palzhj/uFCv2/UFCV2.pdf

# CLK

FPGA_TDO MGTCLK¹¹⁵_P⁰ MGTCLK¹¹⁵_N⁰ | MGTCLK¹¹⁵_P¹ MGTCLK¹¹⁵_N¹ | MGTCLK¹¹⁶_P⁰ MGTCLK¹¹⁶_N⁰ | MGTCLK¹¹⁶_P¹ MGTCLK¹¹⁶_N¹ | MGTCLK¹¹⁷_P⁰ MGTCLK¹¹⁷_N⁰ | MGTCLK¹¹⁷_P¹ MGTCLK¹¹⁷_N¹ | MGTCLK¹¹⁸_P⁰ MGTCLK¹¹⁸_N⁰ | MGTCLK¹¹⁸_P¹ MGTCLK¹¹⁸_N¹

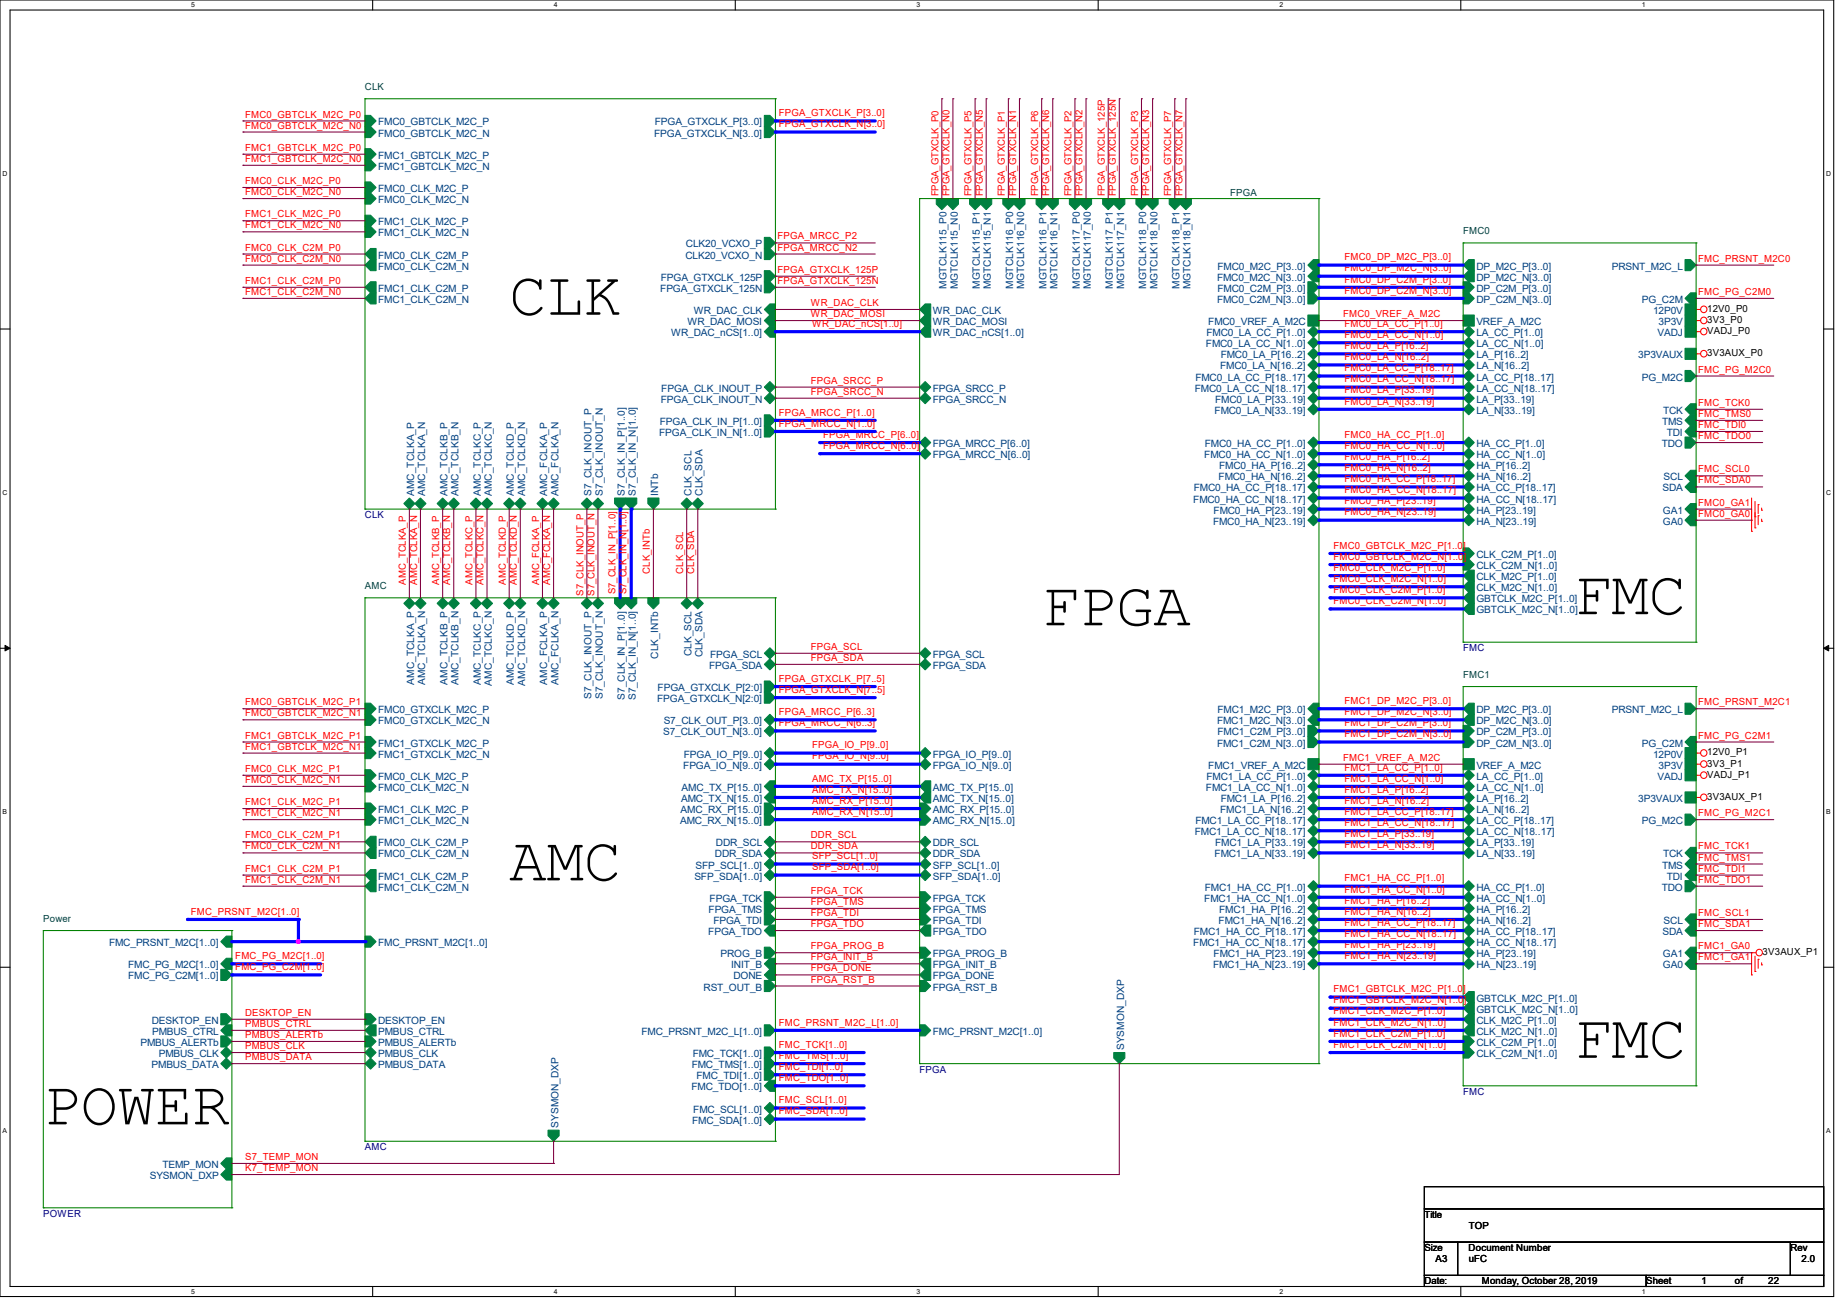
[picture p5: page 1]
FPGA; AMC; FMC; POWER; VADJ_P0; VADJ_P1; 3V3AUX_P0; 3V3AUX_P1; 3V3AUX_P1 Title Size; Document Number; Rev Date:; Sheet; of uFC; 2.0 TOP; Monday, October 28, 2019; 22 Title Size; FMC0_LA_CC_N[18..17] FMC0_LA_N[33..19] FMC0_LA_P[33..19] FMC0_LA_CC_P[18..17] FMC0_HA_CC_P[1..0] FMC0_HA_CC_N[1..0] FMC0_HA_N[16..2] FMC0_HA_P[16..2] FMC0_HA_CC_P[18..17] FMC0_HA_P[23..19] FMC0_HA_N[23..19] FMC0_HA_CC_N[18..17] FPGA_SCL FPGA_SDA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

# MP_3V3 MP_3V3 AMC_MP_3V3

J1GND 85 PWR 84 PS0# 83 GND 82 FCLKA- 81 FCLKA+ 80 GND 79 TCLKB- 78 TCLKB+ 77 GND 76 TCLKA- 75 TCLKA+ 74 GND 73 PWR 72 SDA_L 71 GND 70 RX7- 69 RX7+ 68 GND 67 TX7- 66 TX7+ 65 GND 64 RX6- 63 RX6+ 62 GND 61 TX6- 60 TX6+ 59 GND 58 PWR 57 SCL_L 56 GND 55 RX5- 54 RX5+ 53 GND 52 TX5- 51 TX5+ 50 GND 49 RX4- 48 RX4+ 47 GND 46 TX4- 45 TX4+ 44 GND 43 PWR 42 ENABLE# 41 GND 40 RX3- 39 RX3+ 38 GND 37 TX3- 36 TX3+ 35 GND 34 RX2- 33 RX2+ 32 GND 31 TX2- 30 TX2+ 29 GND 28 PWR 27 GA2 26 GND 25 RX1- 24 RX1+ 23 GND 22 TX1- 21 TX1+ 20 GND 19 PWR 18 GA1 17 GND 16 RX0- 15 RX0+ 14 GND 13 TX0- 12 TX0+ 11 GND 10 PWR 9 RSRVD8 8 GND 7 RSRVD6 6 GA0 5 MP 4 PS1# 3 PWR 2 GND 1

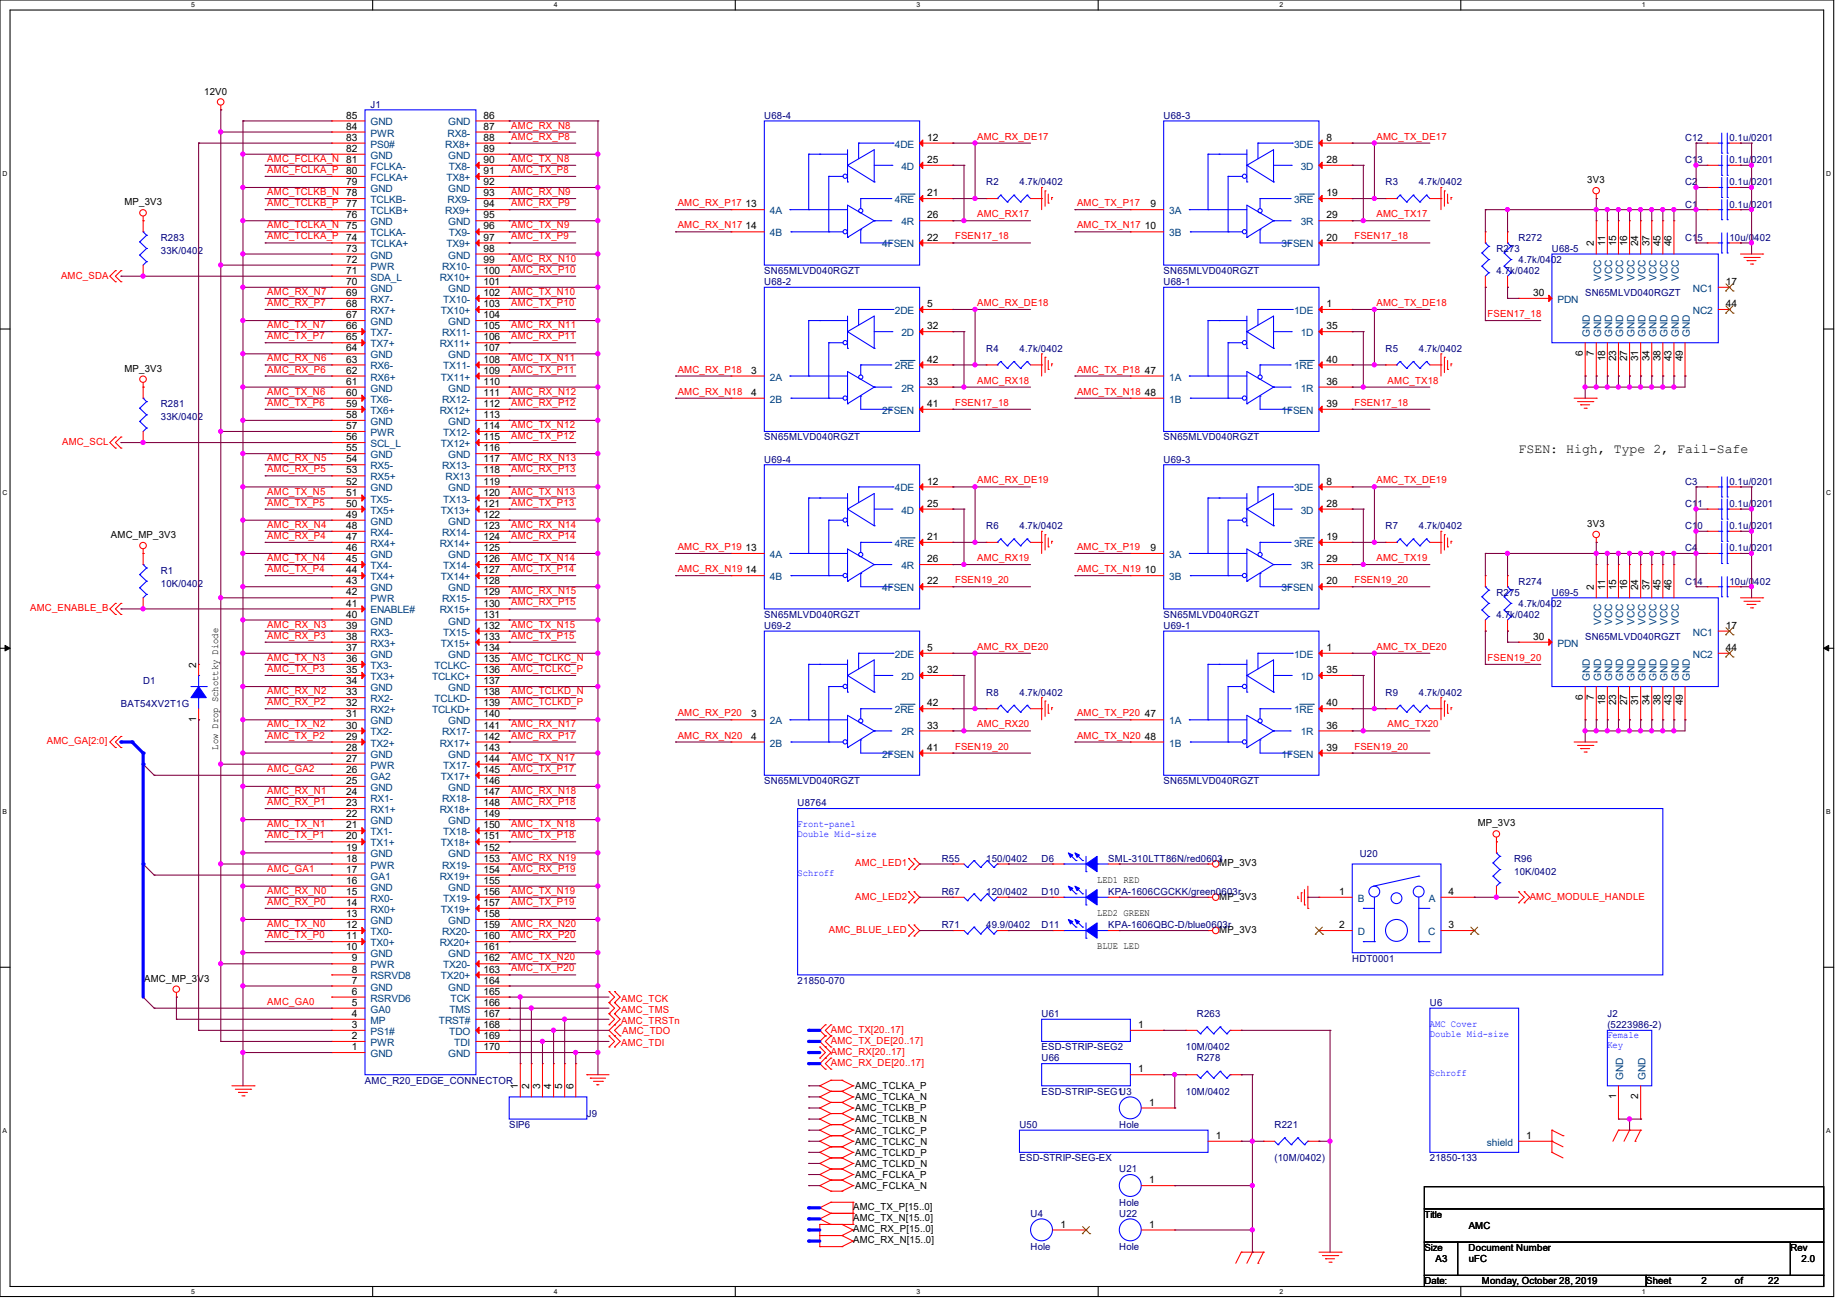
[picture p6: page 2]

GND 86 RX8- 87 RX8+ 88 GND 89 TX8- 90 TX8+ 91 GND 92 RX9- 93 RX9+ 94 GND 95 TX9- 96 TX9+ 97 GND 98 RX10- 99 RX10+ 100 GND 101 TX10- 102 TX10+ 103 GND 104 RX11- 105 RX11+ 106 GND 107 TX11- 108 TX11+ 109 GND 110 RX12- 111 RX12+ 112 GND 113 TX12- 114 TX12+ 115 GND 116 RX13- 117 RX13 118 GND 119 TX13- 120 TX13+ 121 GND 122 RX14- 123 RX14+ 124 GND 125 TX14- 126 TX14+ 127 GND 128 RX15- 129 RX15+ 130 GND 131 TX15- 132 TX15+ 133 GND 134 TCLKC- 135 TCLKC+ 136 GND 137 TCLKD- 138 TCLKD+ 139 GND 140 RX17- 141 RX17+ 142 GND 143 TX17- 144 TX17+ 145 GND 146 RX18- 147 RX18+ 148 GND 149 TX18- 150 TX18+ 151 GND 152 RX19- 153 RX19+ 154 GND 155 TX19- 156 TX19+ 157 GND 158 RX20- 159 RX20+ 160 GND 161 TX20- 162 TX20+ 163 GND 164 TCK 165 TMS 166 TRST# 167 TDO 168 TDI 169 GND 170
AMC_RX_N8 AMC_RX_P8 AMC_TX_N8 AMC_TX_P8 AMC_RX_N9 AMC_RX_N10 AMC_RX_N11 AMC_RX_P9 AMC_RX_P10 AMC_RX_P11 AMC_TX_N9 AMC_TX_N10 AMC_TX_N11 AMC_TX_P9 AMC_TX_P10 AMC_TX_P11

2 VCC 11 VCC 15 VCC 16 VCC 37 VCC 45 VCC 46 VCC 24 GND 49 PDN 30 NC1 17 NC2 44
U68-5 SN65MLVD040RGZT GND

7 GND 23 GND 38 GND 27 GND 34 GND 31 GND 43 VCC

FSEN: High, Type 2, Fail-Safe

A A Low Drop Schottky Diode

U50 ESD-STRIP-SEG-EX

# DONE RST_OUT_B

# AMC_TDI AMC_RX[20..17] AMC_RX_DE[20..17] AMC_TX_DE[20..17] AMC_TX[20..17] FPGA_PROG_B

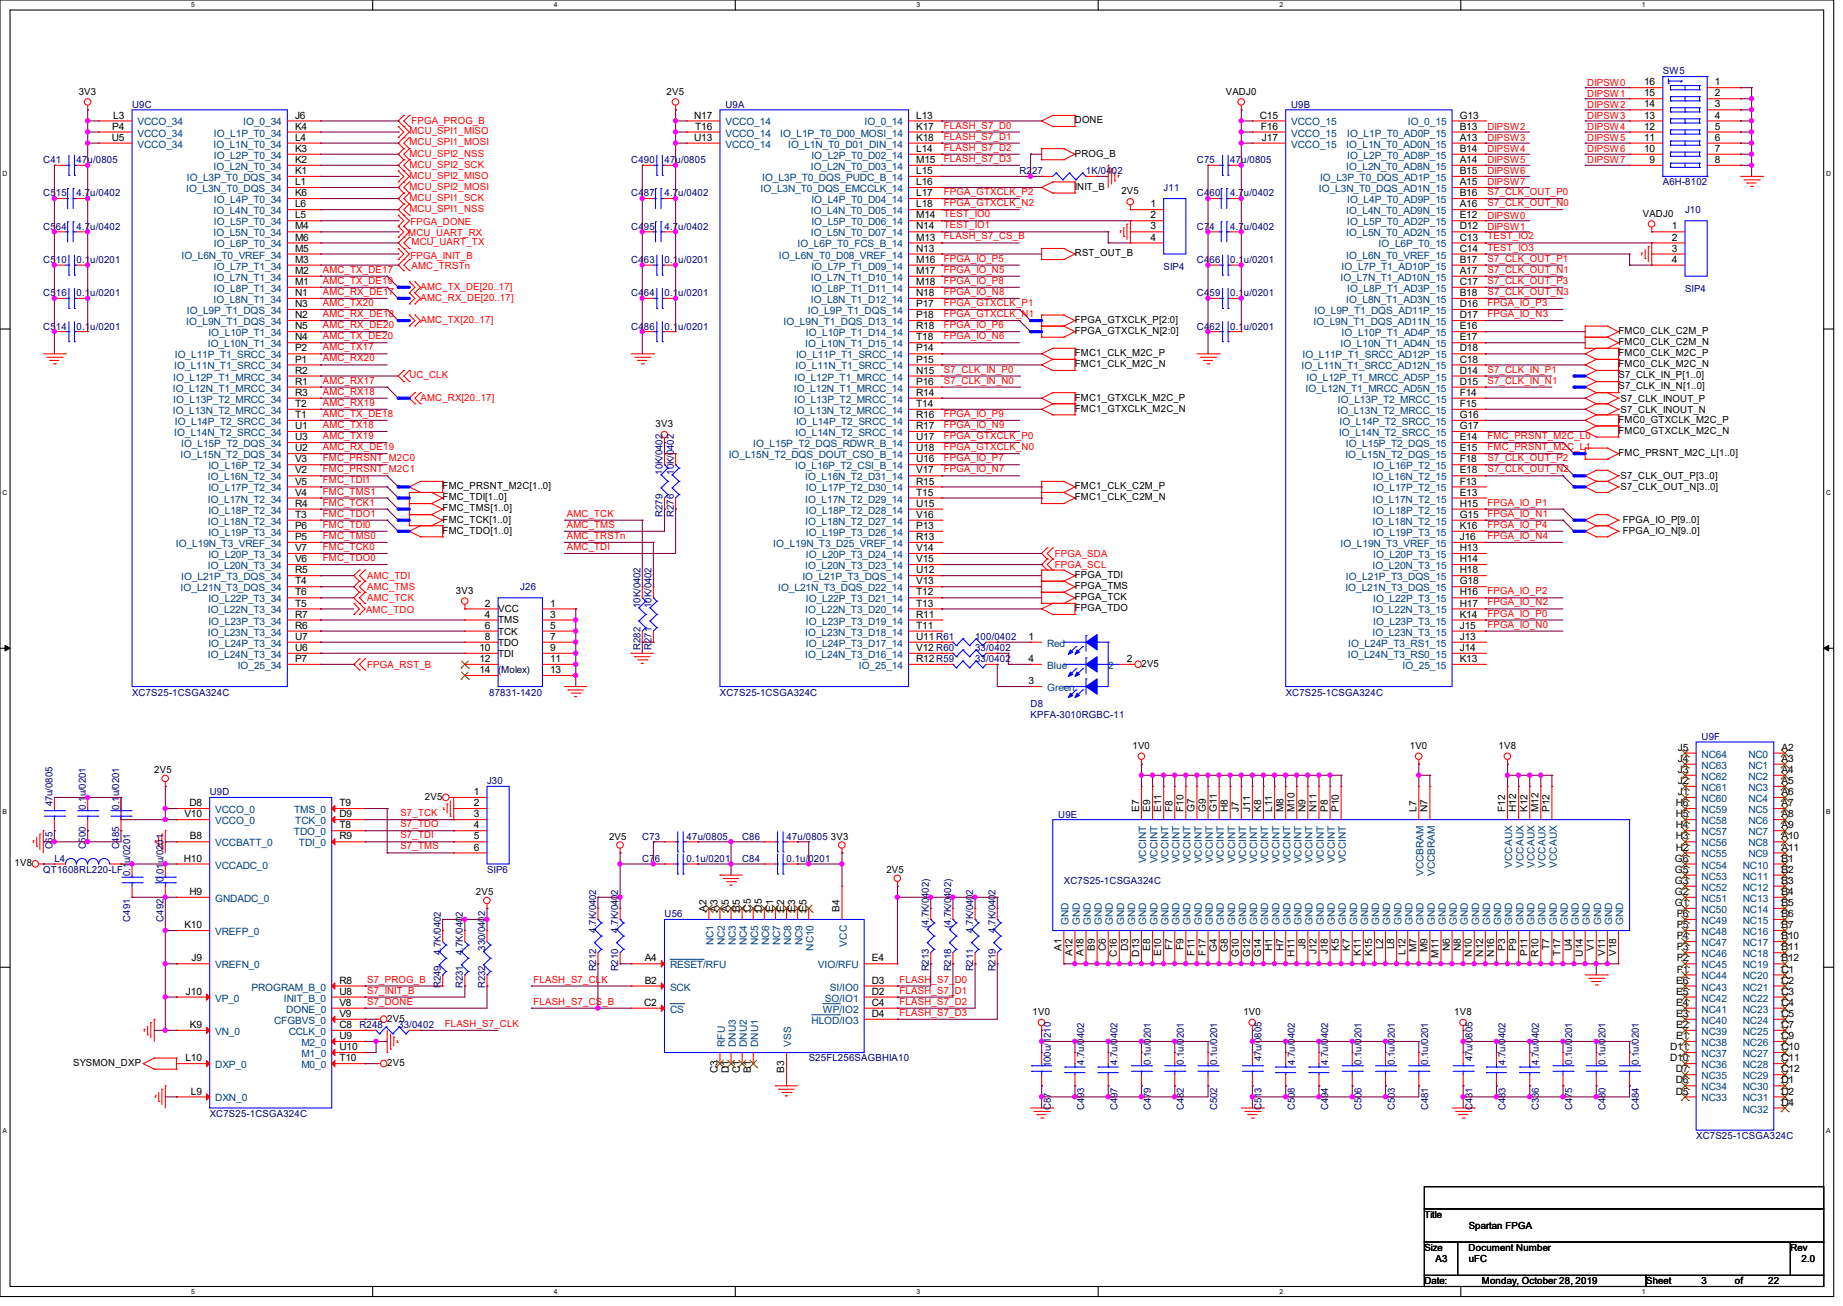
[picture p7: page 3]

## CLK_INTb

## PMBUS_CTRL

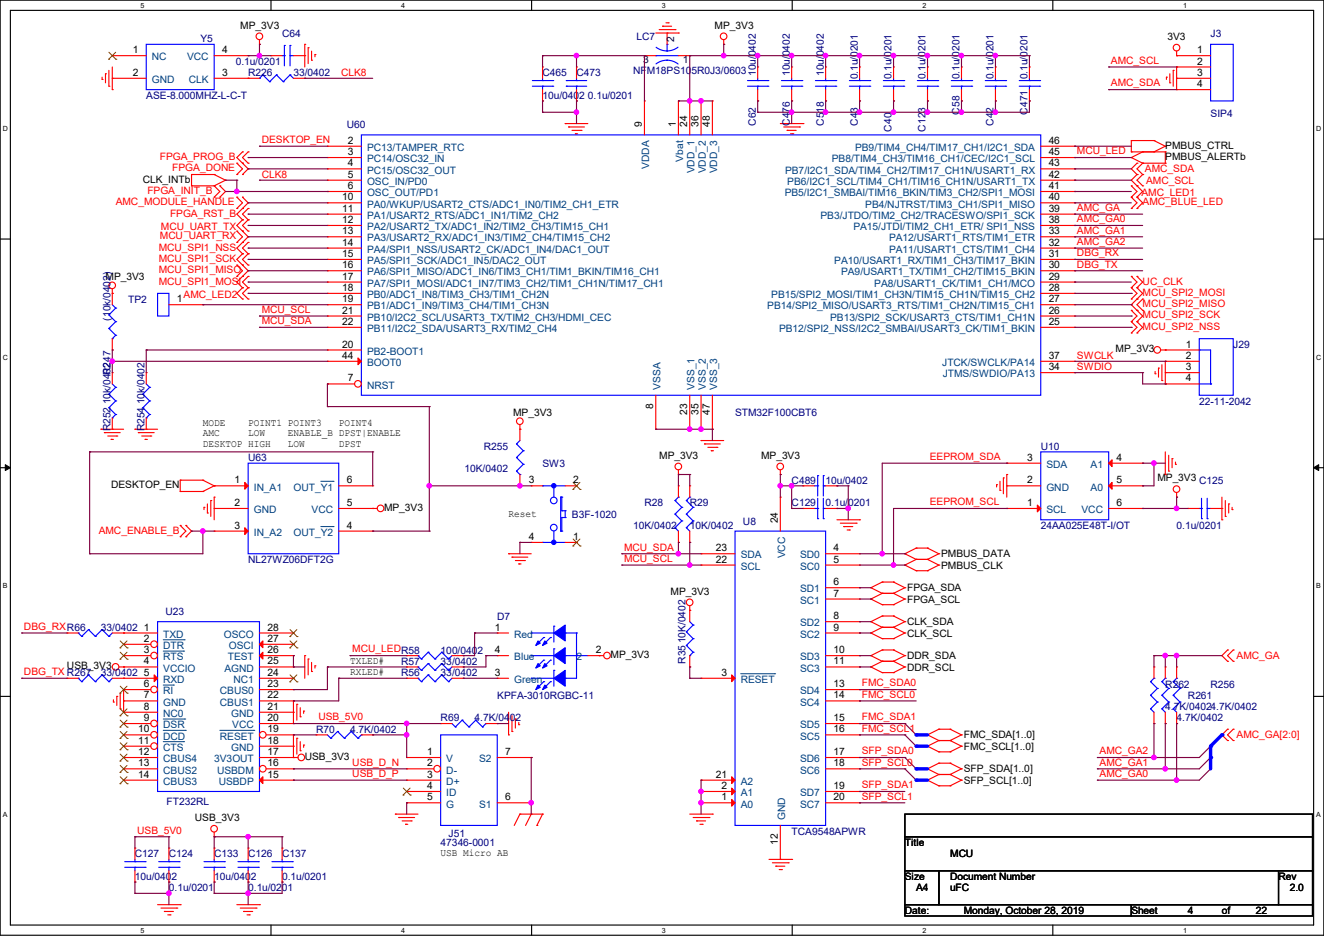
[picture p8: page 4]

PA15/JTDI/TIM2_CH1_ETR/ SPI1_NSS 38 PB3/JTDO/TIM2_CH2/TRACESWO/SPI1_SCK 39 PB4/NJTRST/TIM3_CH1/SPI1_MISO 40 PB5/I2C1_SMBAl/TIM16_BKIN/TIM3_CH2/SPI1_MOSI 41 PB6/I2C1_SCL/TIM4_CH1/TIM16_CH1N/USART1_TX 42 PB7/I2C1_SDA/TIM4_CH2/TIM17_CH1N/USART1_RX 43

10/0402 C⁵⁶ ⁰.1u/0201 | C³² ⁰.1u/0201 | C²⁶ ⁰.1u/0201 | R253 | 10K/0402

# U39 CDCM61004RHBT

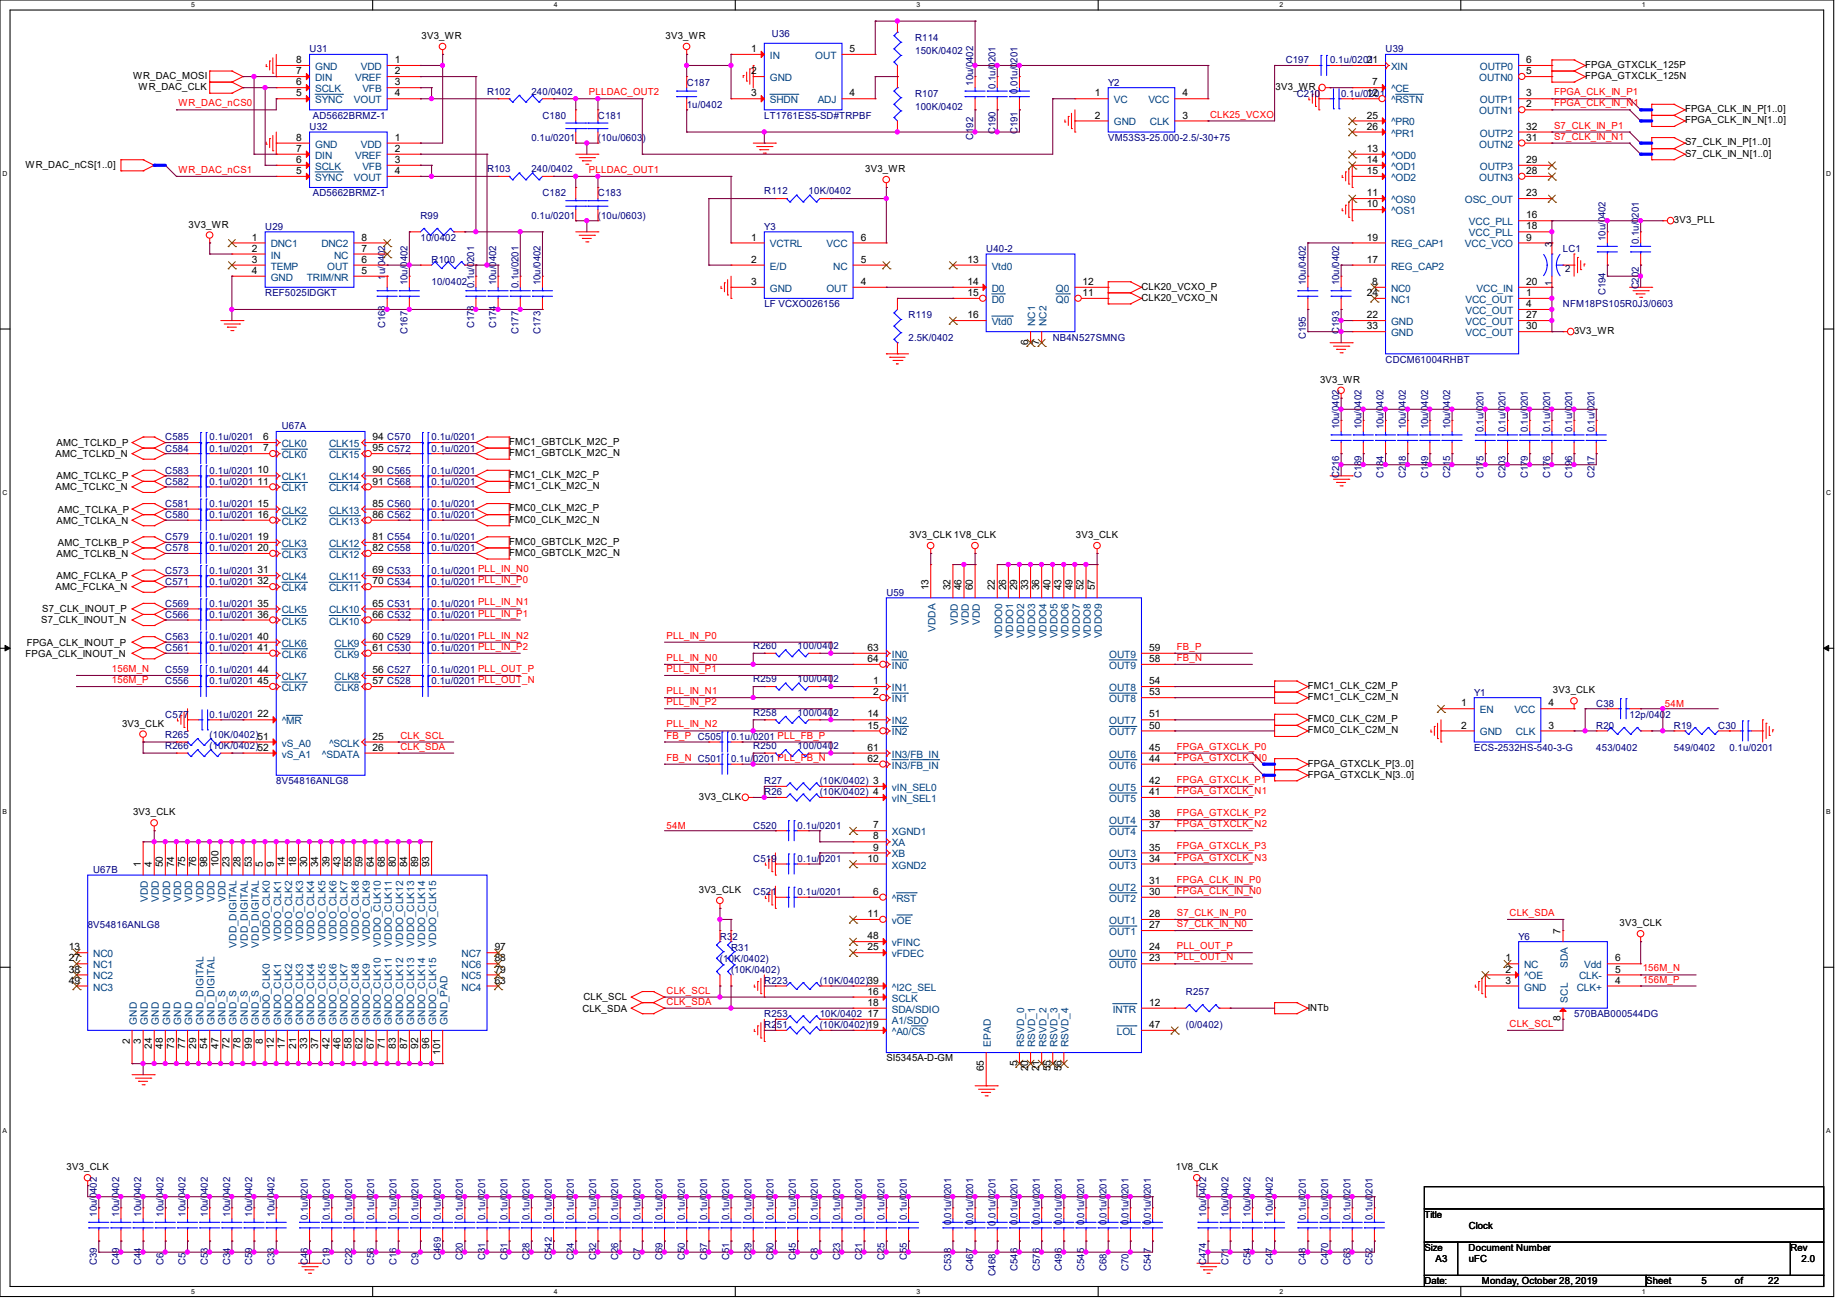
[picture p9: page 5]

PLL_IN_P0 PLL_IN_N0 CLK_SDA CLK_SCL
IN2 15 SCLK 16 A1/SDO 17 SDA/SDIO 18

4 VDD 50 VDD 74 VDD 75 VDD 76 VDD 98 VDD 100 VDDO_CLK0

3 GND 24 GND 48 GND 73 GND 77 GNDO_CLK0

# LA26_N D27 TCK D29 TDI D30 TDO D31 TMS D33 TRST_L D34 GA1 D35 PG_C2M D1

J32-5 HA01_P_CC E2 HA01_N_CC E3 HA05_P E6 HA05_N E7 HA09_P E9 HA09_N E10 HA13_P E12 HA13_N E13 HA16_P E15 HA16_N E16 HA20_P E18 HA20_N E19 HB03_P E21 HB03_N E22 HB05_P E24 HB05_N E25 HB09_P E27 HB09_N E28 HB13_P E30 HB13_N E31 HB19_P E33 HB19_N E34 HB21_P E36 HB21_N E37

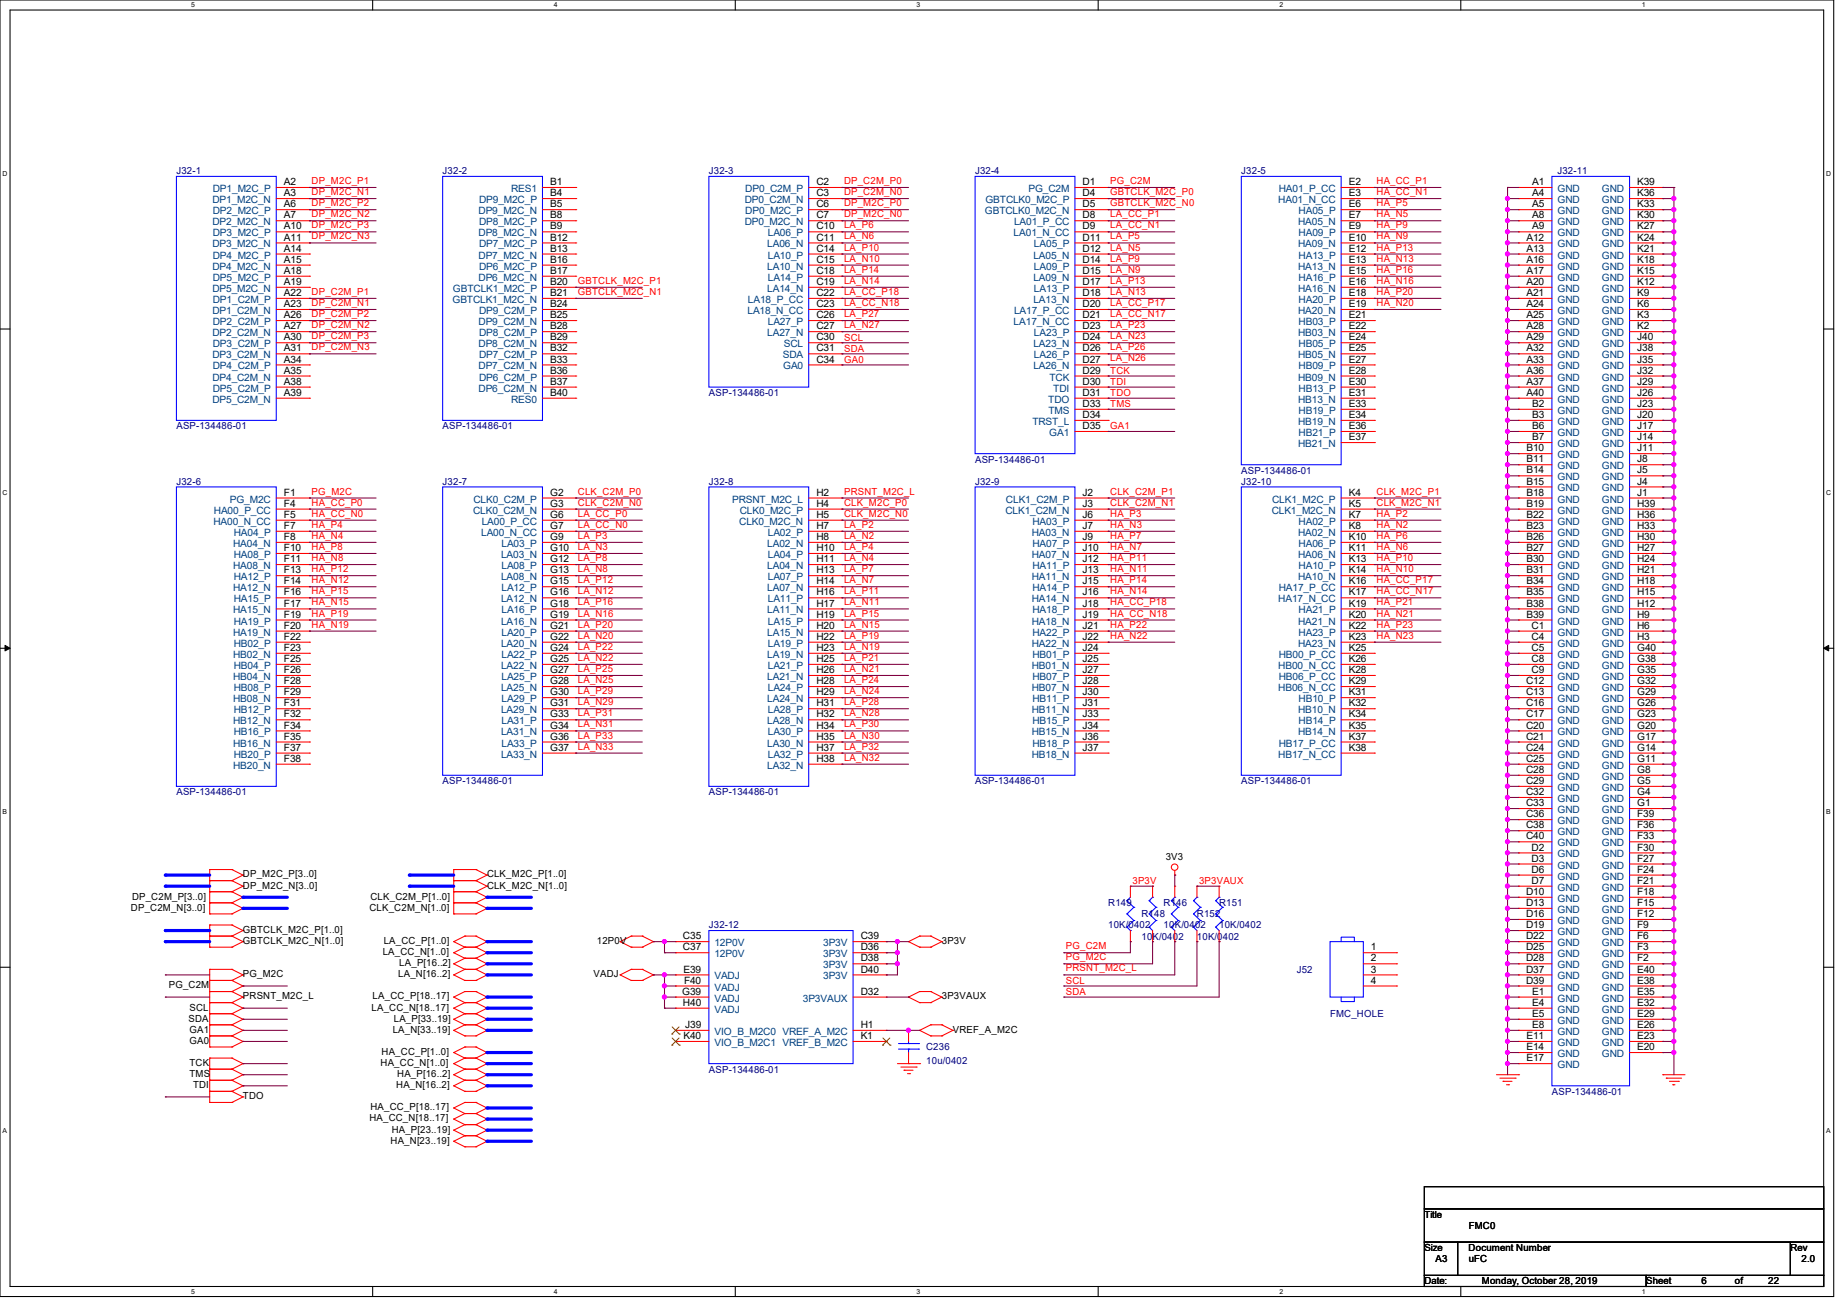
[picture p10: page 6]

# LA26_N D27 TCK D29 TDI D30 TDO D31 TMS D33 TRST_L D34 GA1 D35 PG_C2M D1

J33-5 HA01_P_CC E2 HA01_N_CC E3 HA05_P E6 HA05_N E7 HA09_P E9 HA09_N E10 HA13_P E12 HA13_N E13 HA16_P E15 HA16_N E16 HA20_P E18 HA20_N E19 HB03_P E21 HB03_N E22 HB05_P E24 HB05_N E25 HB09_P E27 HB09_N E28 HB13_P E30 HB13_N E31 HB19_P E33 HB19_N E34 HB21_P E36 HB21_N E37

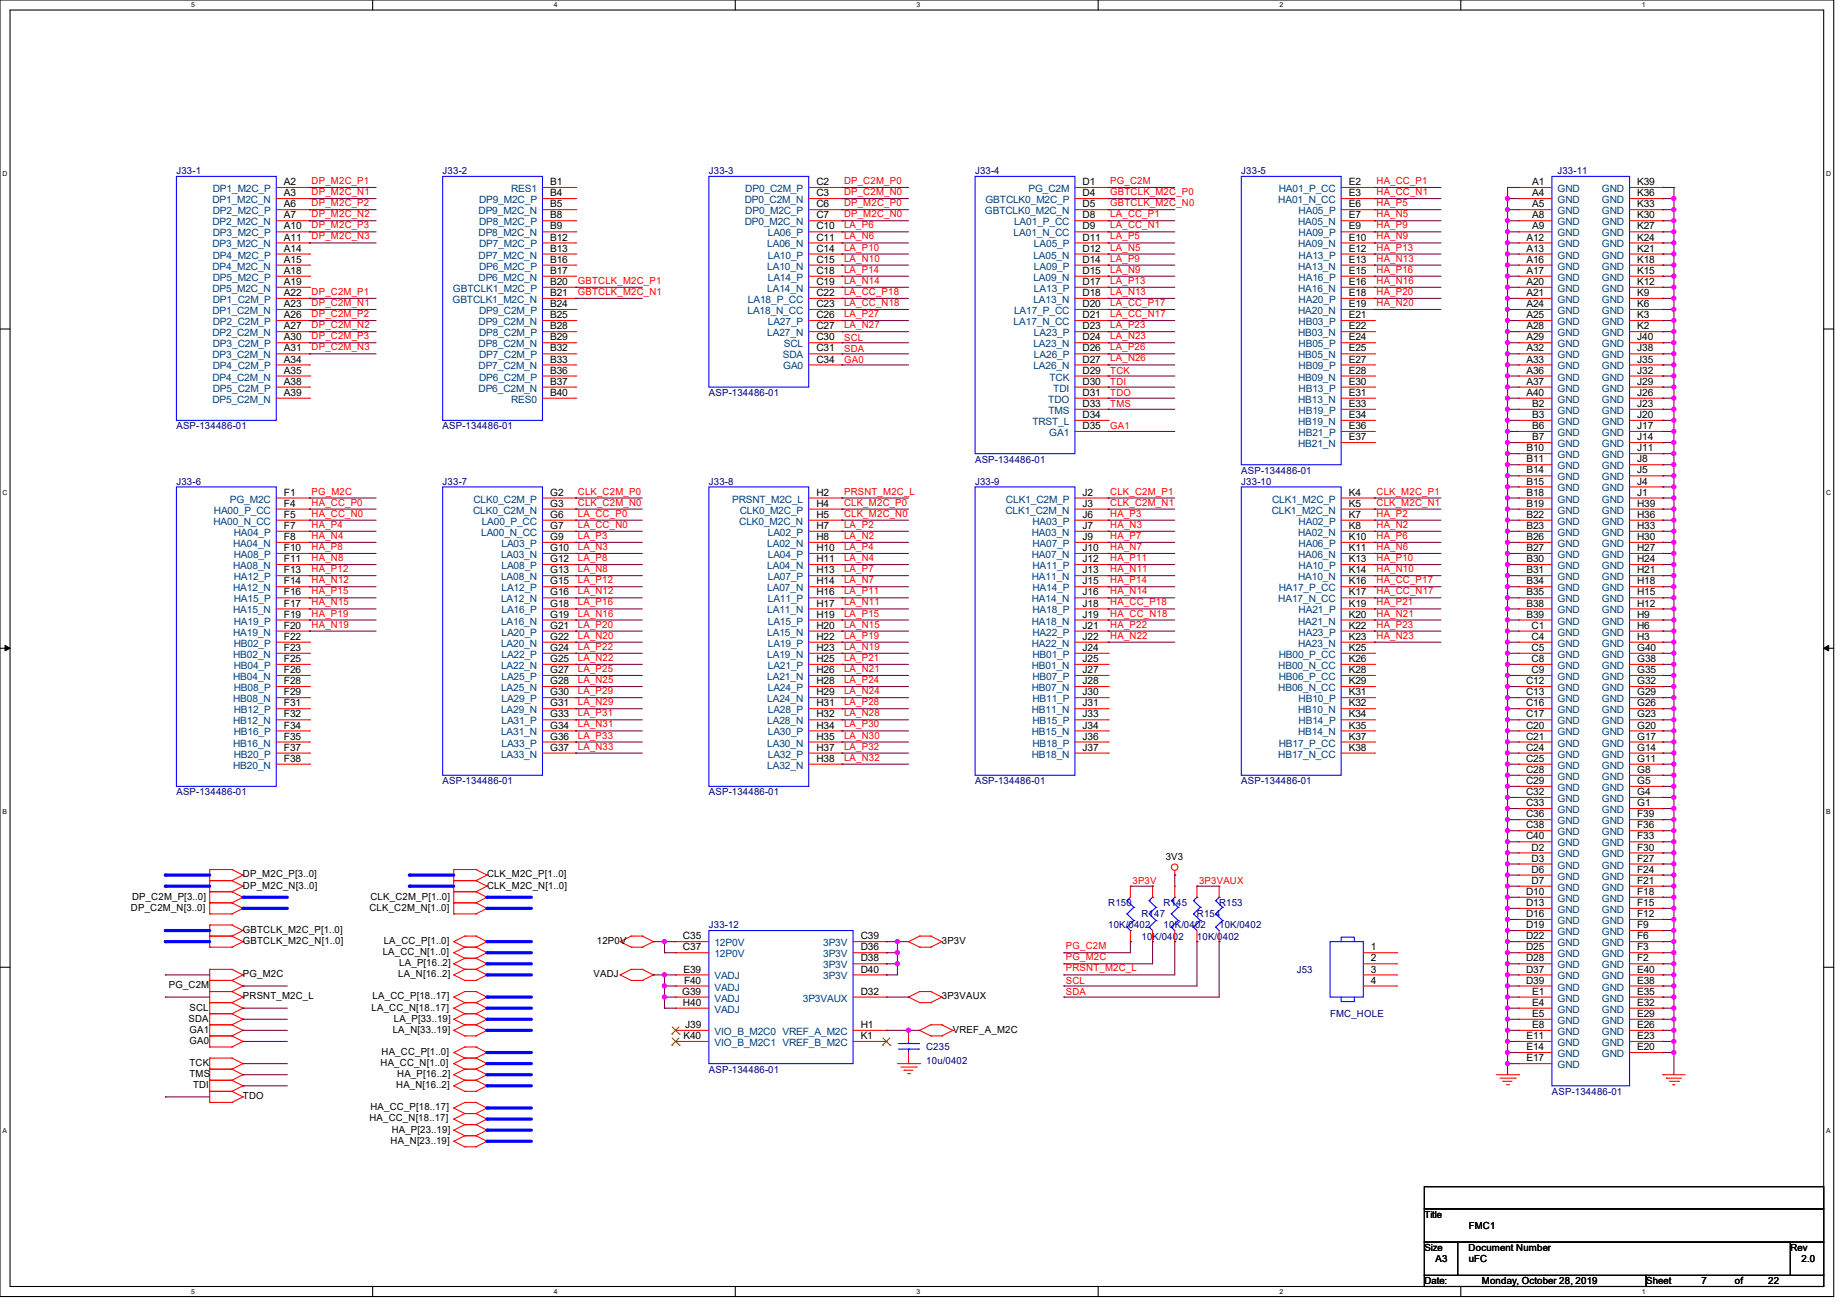
[picture p11: page 7]

LEMO_INOUT1 AMC_TX_P13 AMC_TX_N13 AMC_TX_N15 AMC_TX_P15 AMC_RX_P14 AMC_RX_N14 AMC_TX_N14 AMC_TX_P14

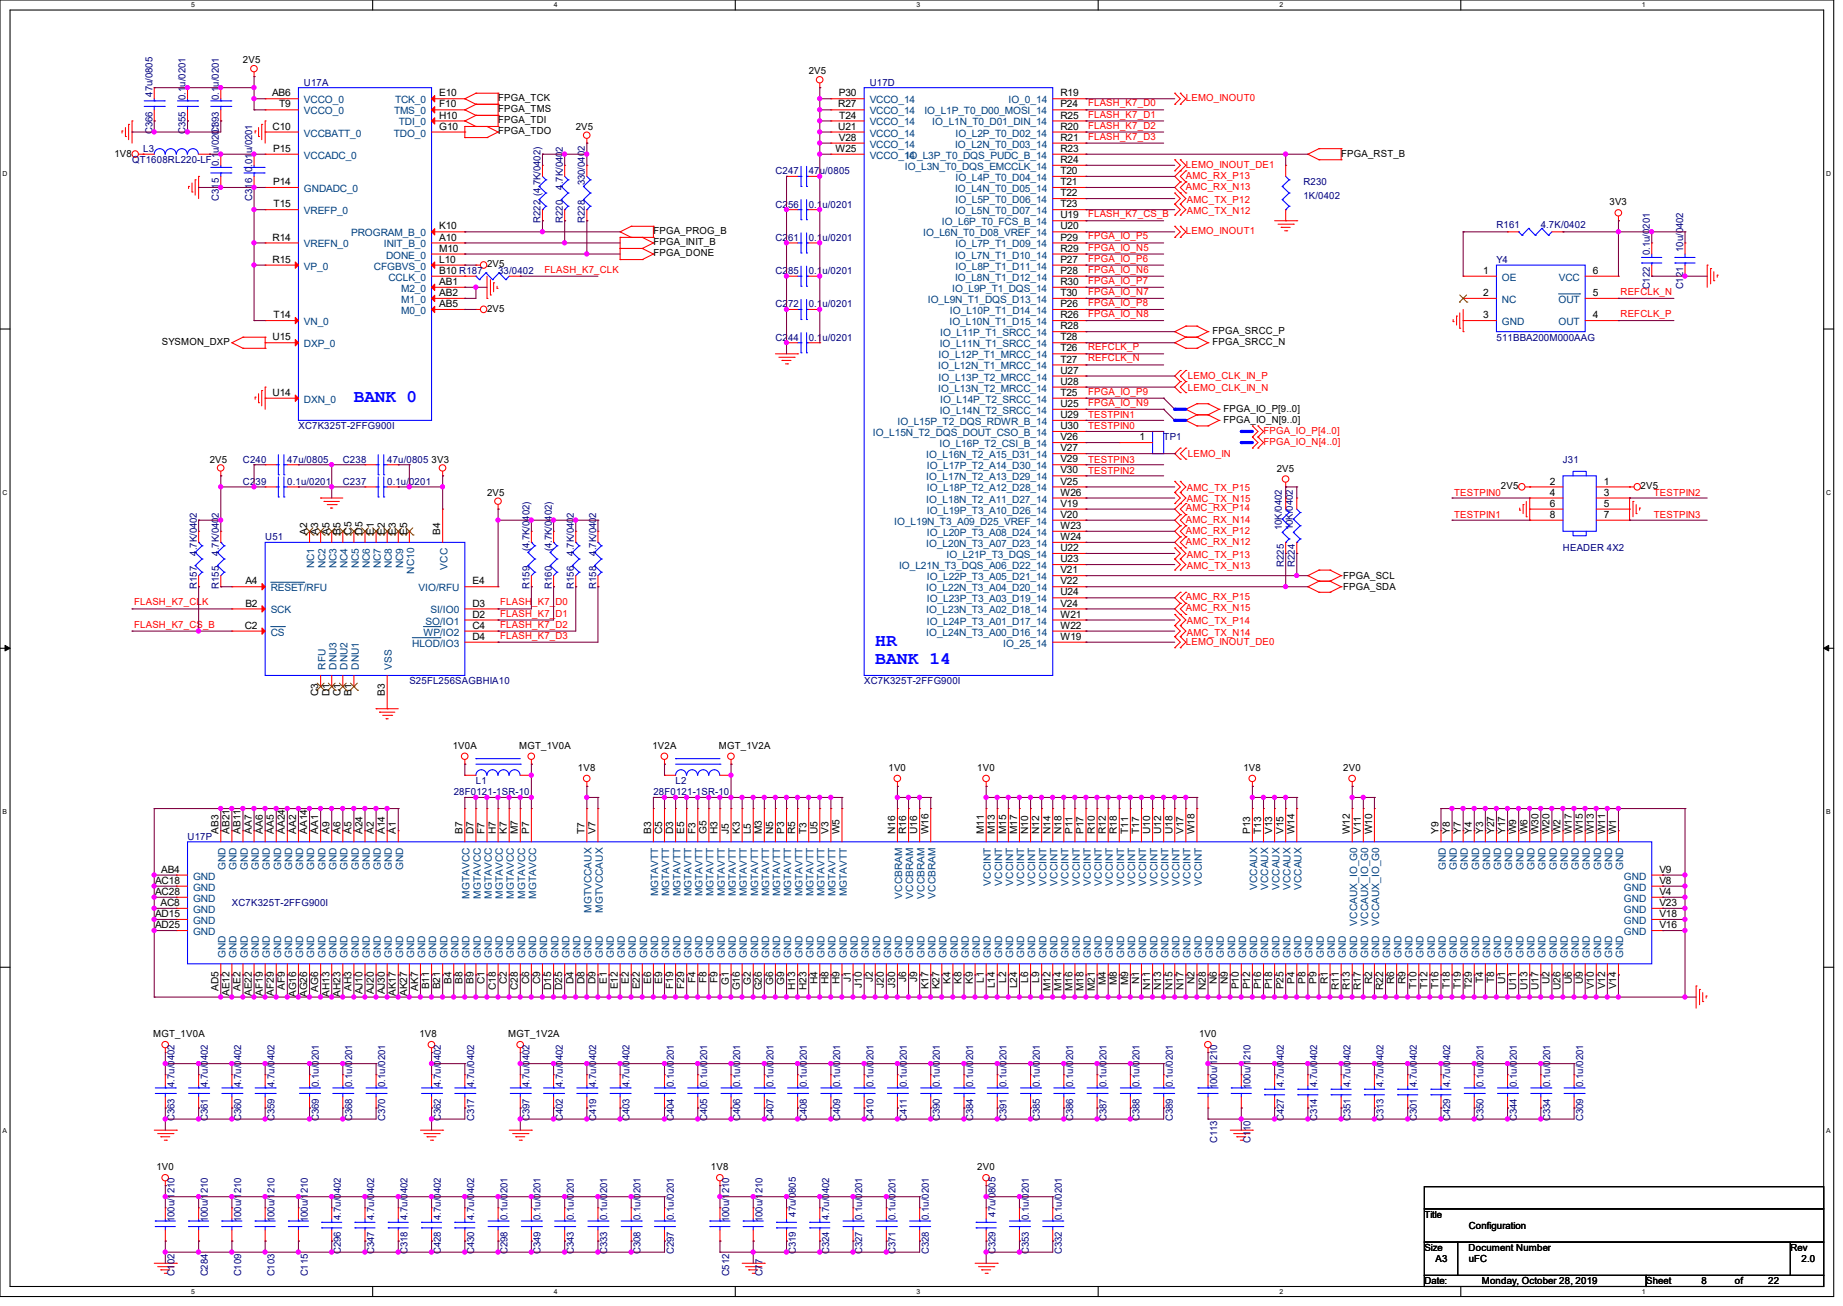
[picture p12: page 8]

# SFP

# SFP_DETECT0 SFP_RX_LOS0 SFP_RX_LOS1 SFP_DETECT1

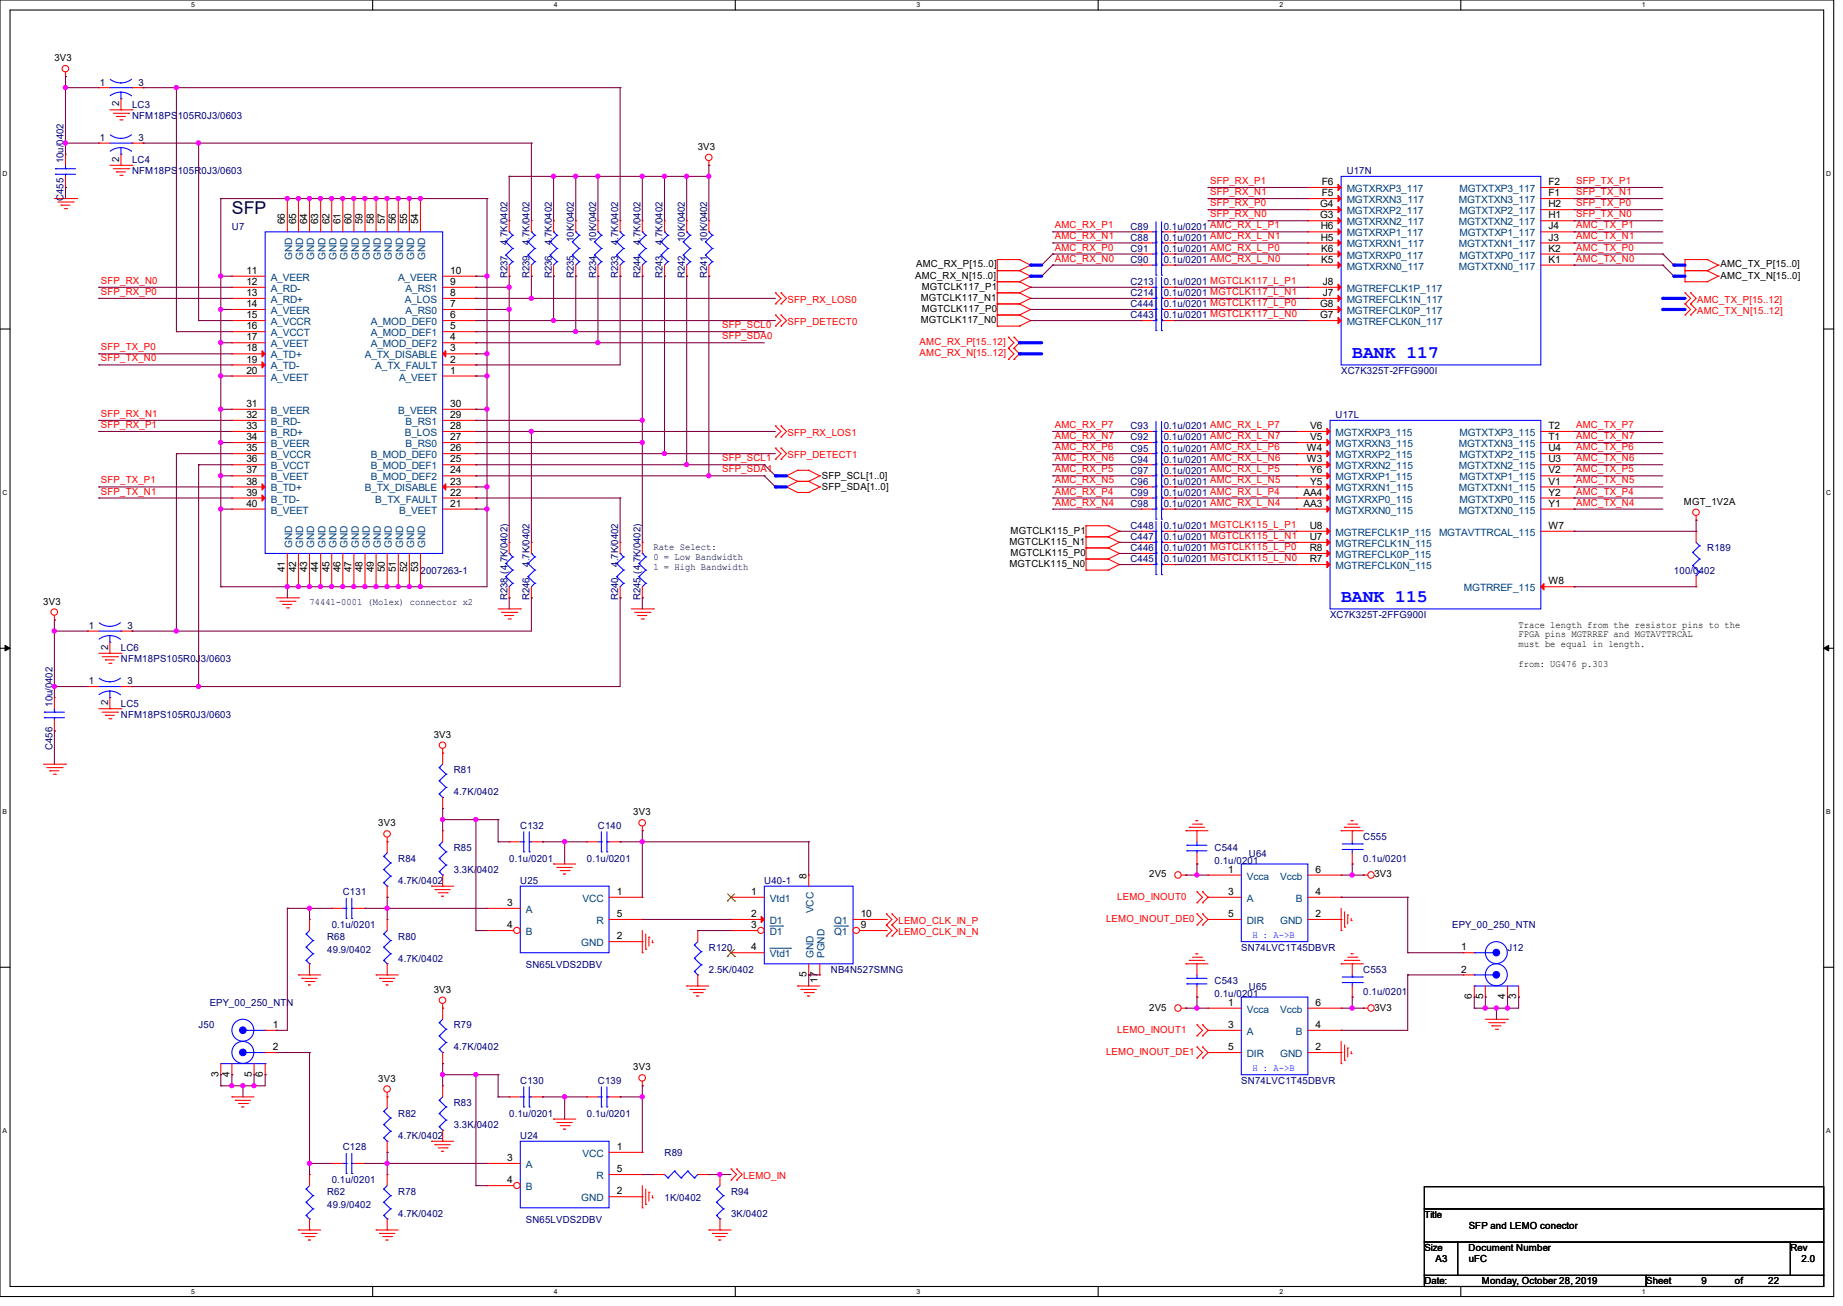
[picture p13: page 9]

Trace length from the resistor pins to the
FPGA pins MGTRREF and MGTAVTTRCAL
must be equal in length.
from: UG476 p.303

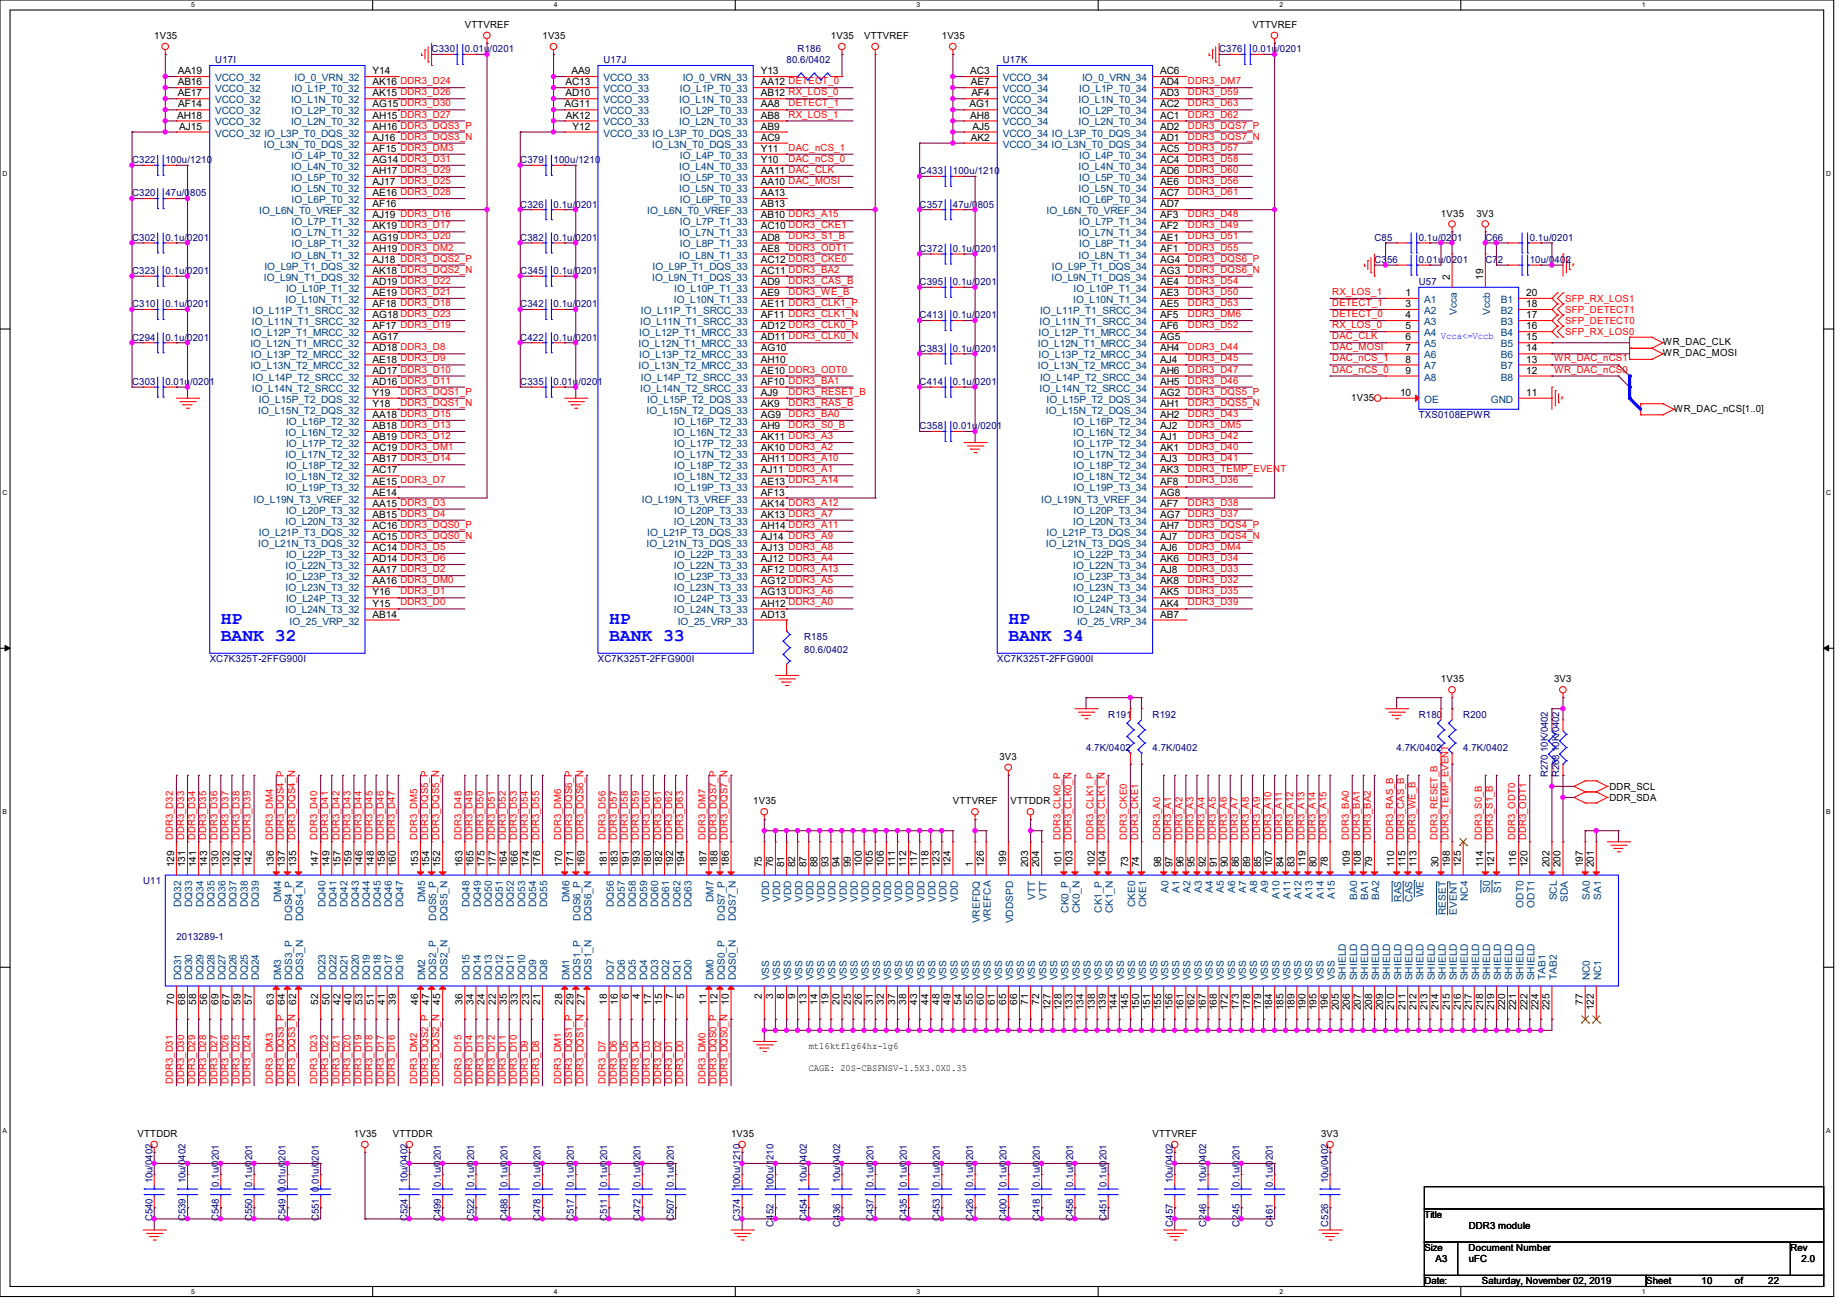
[picture p14: page 10]

9 VSS 13 VSS 14 VSS 19 VSS 20 VSS 25 VSS 26 VSS 31 VSS 32 VSS 37 VSS 38 VSS 43 VSS 44 VSS 48 VSS 49 VSS 54 VSS 55 VSS 60 VSS 61 VSS 65 VSS 66 VSS 71 VSS 72 VSS 127 VSS 128 VSS 133 VSS 134 VSS 138 VSS 139 VSS 144 VSS 145 VSS 150 VSS 151 VSS 155 VSS 156 VSS 161 VSS 162 VSS 167 VSS 168 VSS 172 VSS 173 VSS 178 VSS 179 VSS 184 VSS 185 VSS 189 VSS 190 VSS 195 VSS 196 SHIELD 205 SHIELD 206 SHIELD 207 SHIELD 208 SHIELD 209 SHIELD 210 SHIELD 211 SHIELD 212 SHIELD 213 SHIELD 214 SHIELD 215 SHIELD 216 SHIELD 217 SHIELD 218 SHIELD 219 SHIELD 220 SHIELD 221 SHIELD 222 TAB1 224 TAB2 225 C400 0.1u/0201 C383 0.1u/0201 C357 47u/0805 C335 0.01u/0201 C548 0.1u/0201 C511 0.1u/0201

2 A2 3 A3 4 A4 5 A5 6 A6 7 A7 8 A8 9 OE 10 GND 11 B1 20 Vccb 19 B8 12 B7 13 B6 14 B5 15 B4 16 B3 17 B2 18 C451 0.1u/0201 C358 0.01u/0201 HP

6 DQ6 16 DQ7 18 DQ8 21 DQ9 23 DQ10 33 DQ11 35 DQ12 22 DQ13 24 DQ14 34 DQ15 36 DQ16 39 DQ17 41 DQ18 51 DQ19 53 DQ20 40 DQ21 42 DQ22 50 DQ23 52 DQ24 57 DQ25 59 DQ26 67 DQ27 69 DQ28 56 DQ29 58 DQ30 68 DQ31 70 DQ32 129 DQ33 131 DQ34 141 DQ35 143 DQ36 130 DQ37 132 DQ38 140 DQ39 142 DQ40 147 DQ41 149 DQ42 157 DQ43 159 DQ44 146 DQ45 148 DQ46 158 DQ47 160 DQ48 163 DQ49 165 DQ50 175 DQ51 177 DQ52 164 DQ53 166 DQ54 174 DQ55 176 DQ56 181 DQ57 183 DQ58 191 DQ59 193 DQ60 180 DQ61 182 DQ62 192 DQ63 194 DQS0_N 10 DQS0_P 12 DQS1_N 27 DQS1_P 29 DQS2_N 45 DQS2_P 47 DQS3_N 62 DQS3_P 64 DQS4_N 135 DQS4_P 137 DQS5_N 152 DQS5_P 154 DQS6_N 169 DQS6_P 171 DQS7_N 186 DQS7_P 188 NC0 77 A15 78 A14 80 NC1 122 NC4 125 ODT0 116 ODT1 120 SA0 197 SA1 201 SCL 202 SDA 200 VDD 75 VDD 76 VDD 81 VDD 82 VDD 87 VDD 88 VDD 93 VDD 94 VDD 99 VDD 100 VDD 105 VDD 106 VDD 111 VDD 112 VDD 117 VDD 118 VDD 123 VDD 124 VDDSPD 199 VREFCA 126 VREFDQ

FMC0_HA_N[16..2] FMC0_HA_P[16..2] FMC0_HA_CC_P[18..17] FMC0_HA_P[23..19] FMC0_HA_N[23..19] FMC0_HA_CC_N[18..17]
FMC0_HA_P13 FMC0_HA_N13 FMC0_HA_P8 FMC0_HA_N8 FMC0_HA_P9 FMC0_HA_N9 FMC0_HA_P4 FMC0_HA_N4 FMC0_HA_P5 FMC0_HA_N5

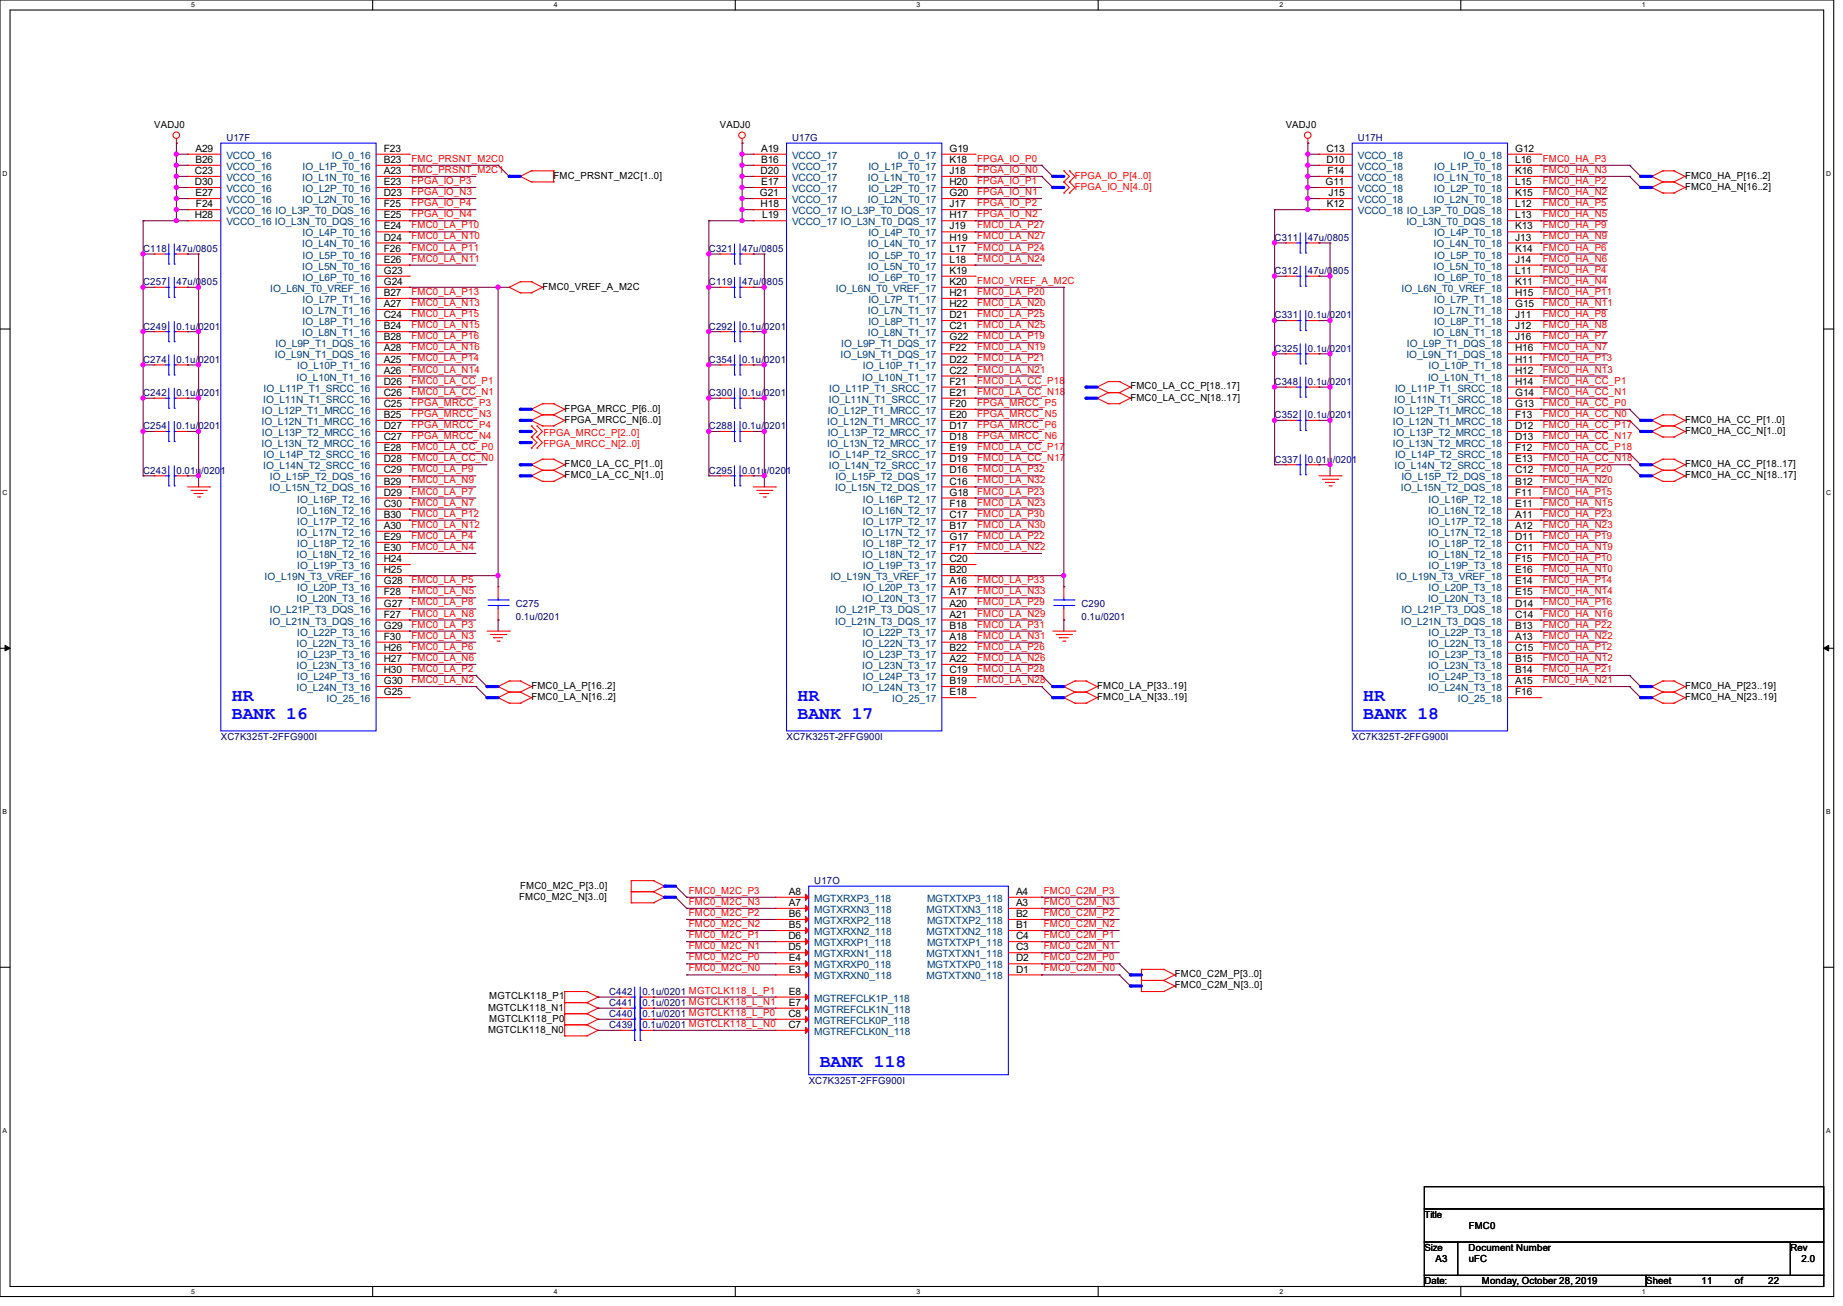
[picture p15: page 11]

# FMC1_HA_P[23..19] FMC1_HA_N[23..19] FMC1_HA_CC_N[18..17]

FMC1_LA_P10 FMC1_LA_N10 FMC1_LA_P11 FMC1_LA_N11 FMC1_LA_P13 FMC1_LA_N13 FMC1_LA_P2 FMC1_LA_N2 FMC1_LA_N4 FMC1_LA_P4 FMC1_LA_P6 FMC1_LA_N6

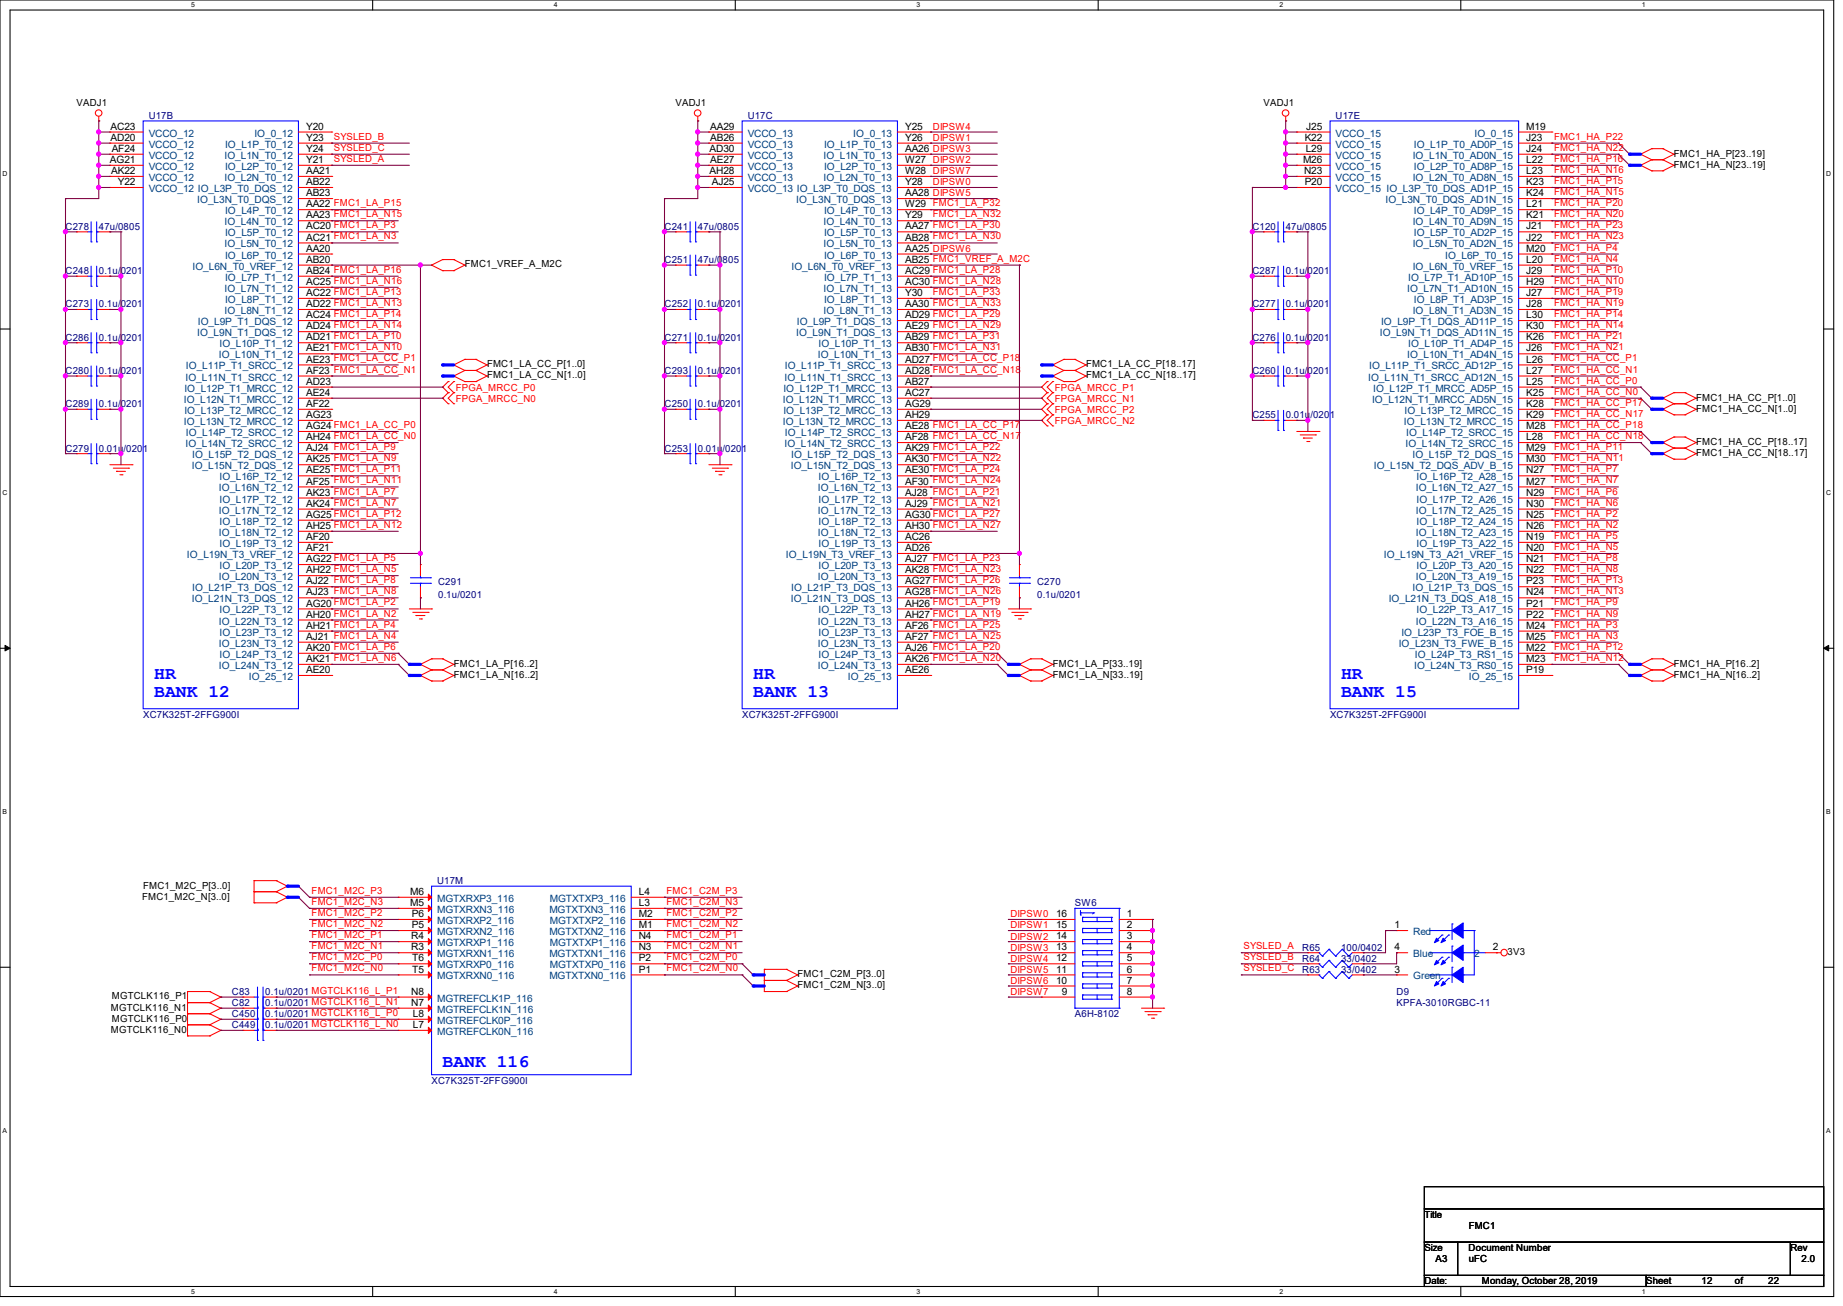
[picture p16: page 12]

100u/1210 R¹²⁶ ¹⁰K/0402 | C²²⁷ ¹⁰u/0402 | +

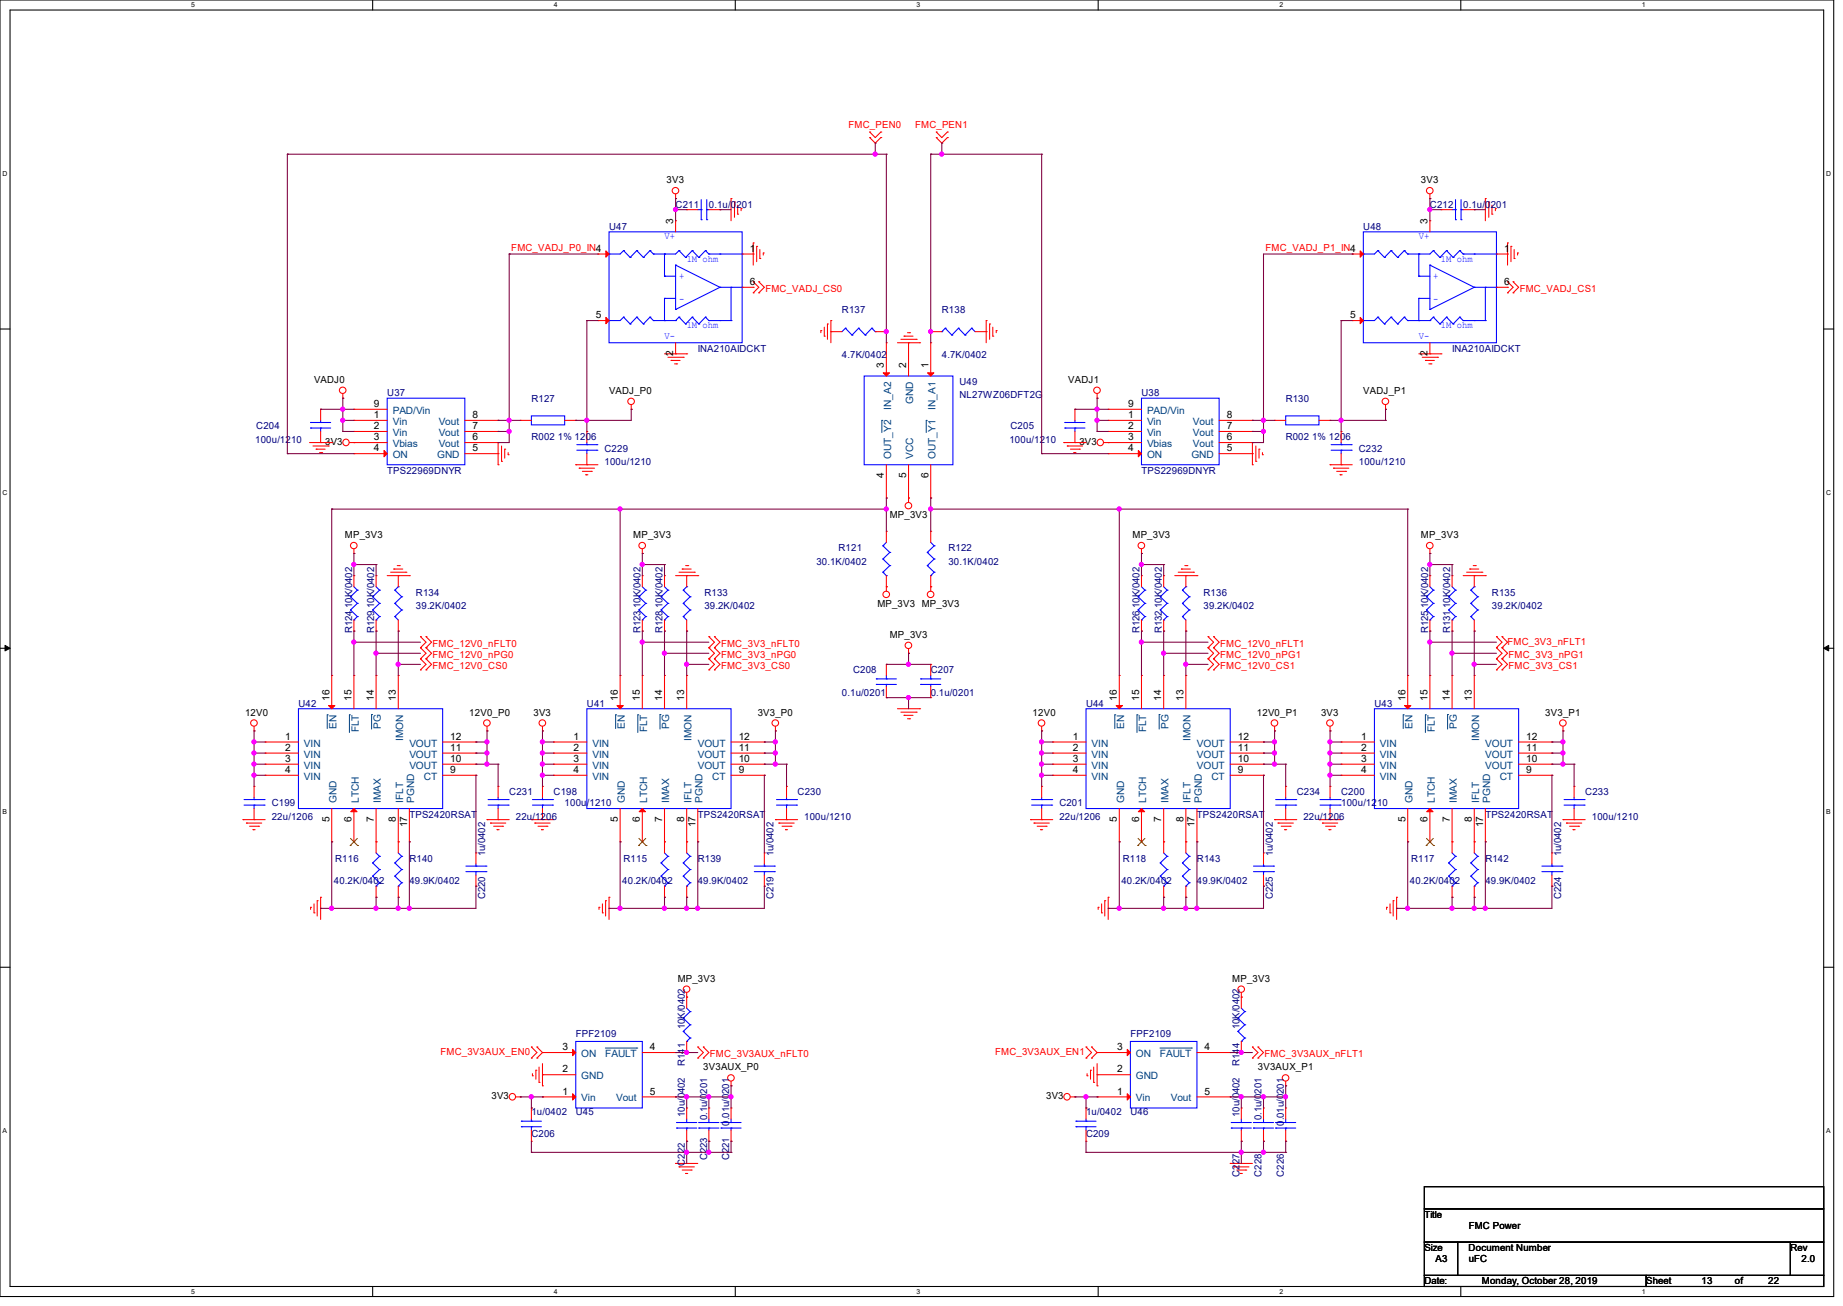
[picture p17: page 13]

8 CT 9 VOUT 10 VOUT 11 VOUT IMON 12 13 PG 14 FLT 15 EN 16 PGND 17 +

49.9K/0402 R¹⁴⁴ ¹⁰K/0402 R¹²⁹ ¹⁰K/0402

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

8 CT 9 VOUT 10 VOUT 11 VOUT IMON 12 13 PG 14 FLT 15 EN 16 PGND 17 C225 1u/0402 R141 10K/0402

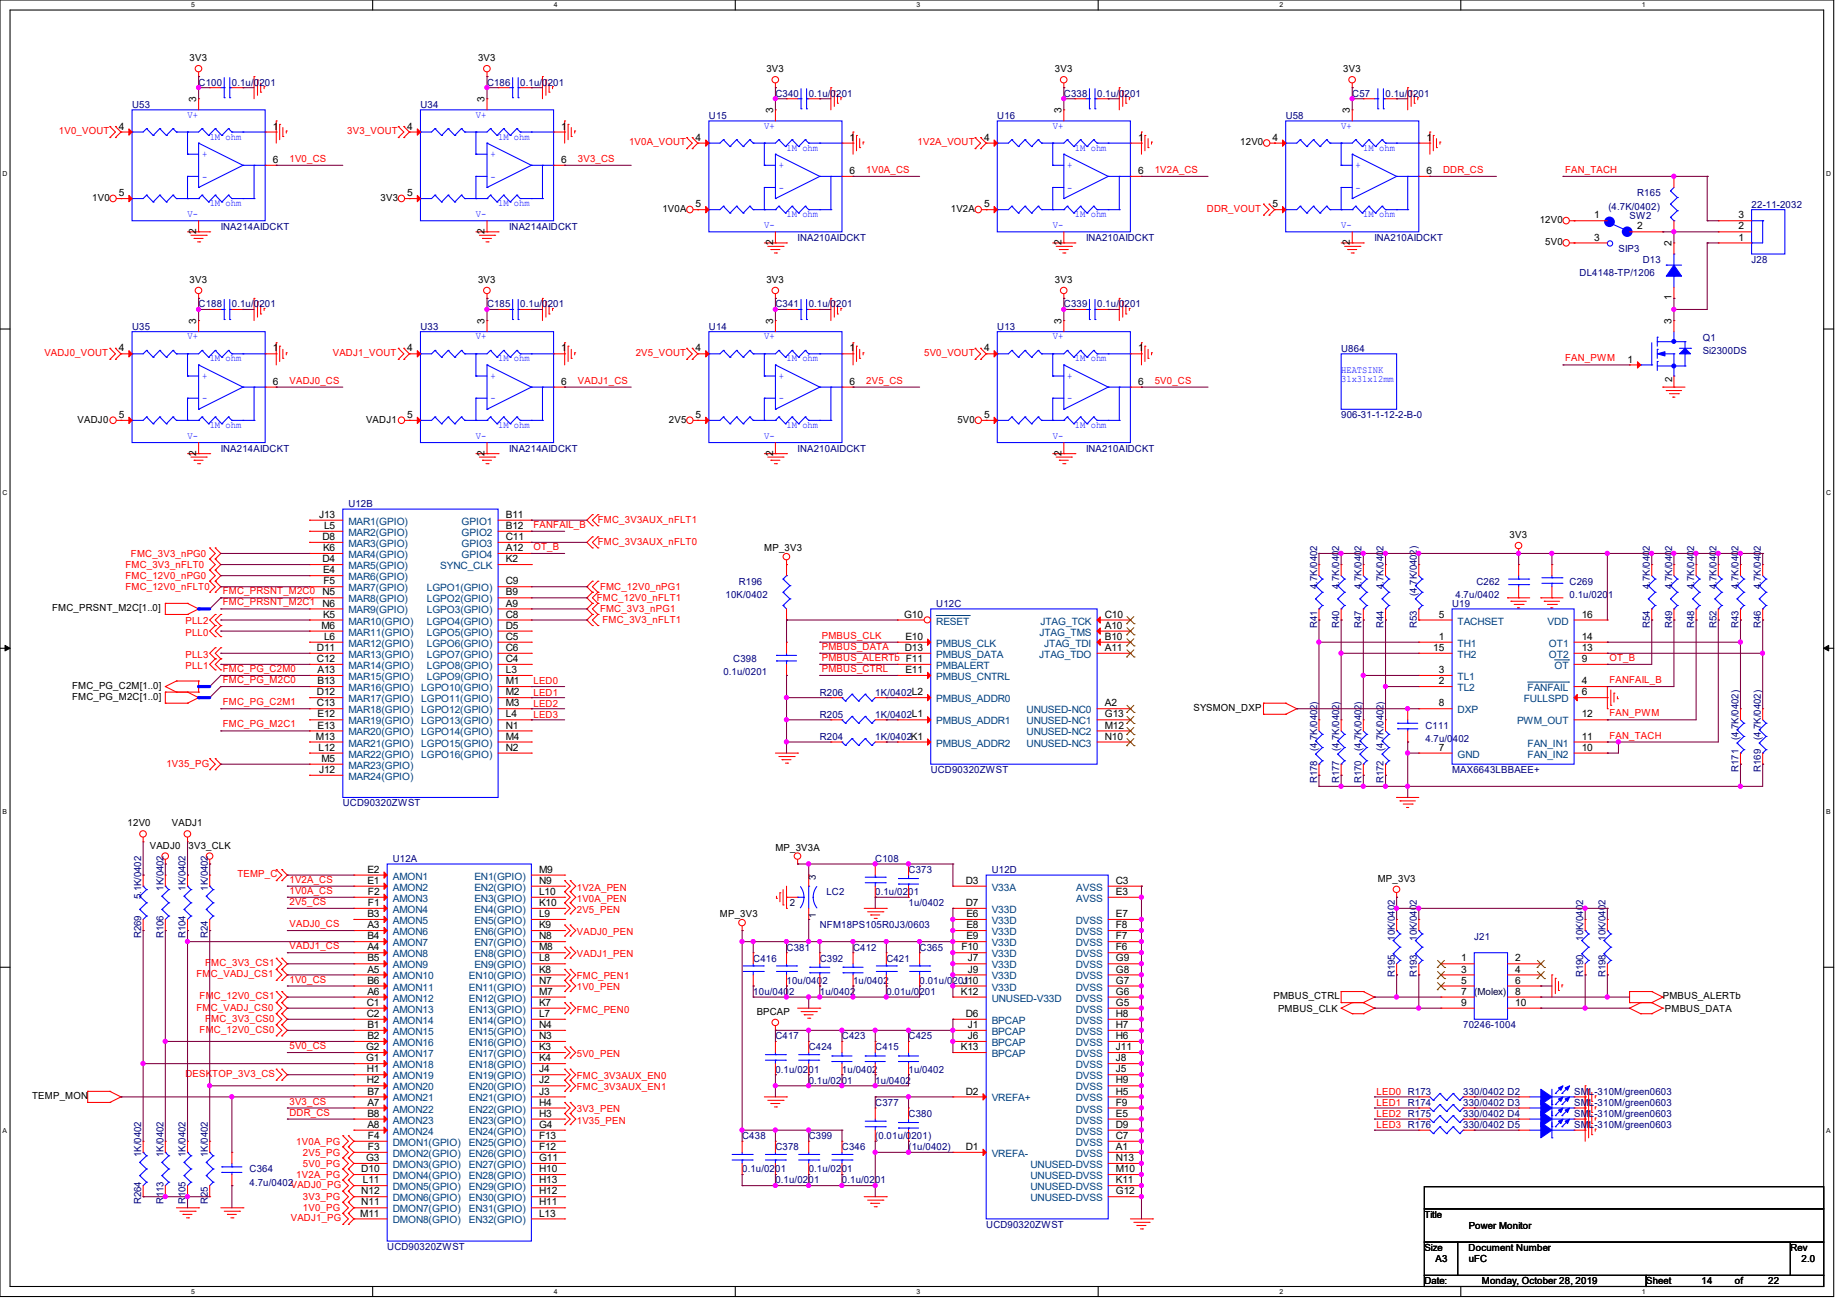
[picture p18: page 14]

LED0
LED1
LED2
EN1(GPIO) M9 EN2(GPIO) N9 EN3(GPIO) L10 EN4(GPIO) K10 EN5(GPIO) L9 EN6(GPIO) K9 EN7(GPIO) N8 EN8(GPIO) M8 EN9(GPIO) L8 EN10(GPIO) K8 EN11(GPIO) N7 EN12(GPIO) M7 EN13(GPIO) K7 EN14(GPIO) L7 EN15(GPIO) N4 EN16(GPIO) N3 EN17(GPIO) K3 EN18(GPIO) K4 EN19(GPIO) J4 EN20(GPIO) J2 EN21(GPIO) J3 EN22(GPIO) H4 EN23(GPIO) H3 EN24(GPIO) G4 EN25(GPIO) F13 EN26(GPIO) F12 EN27(GPIO) G11 EN28(GPIO) H10 EN29(GPIO) H13 EN30(GPIO) H12 EN31(GPIO) H11 EN32(GPIO) L13

# PLL0 PLL1

# LTM4601 VIN

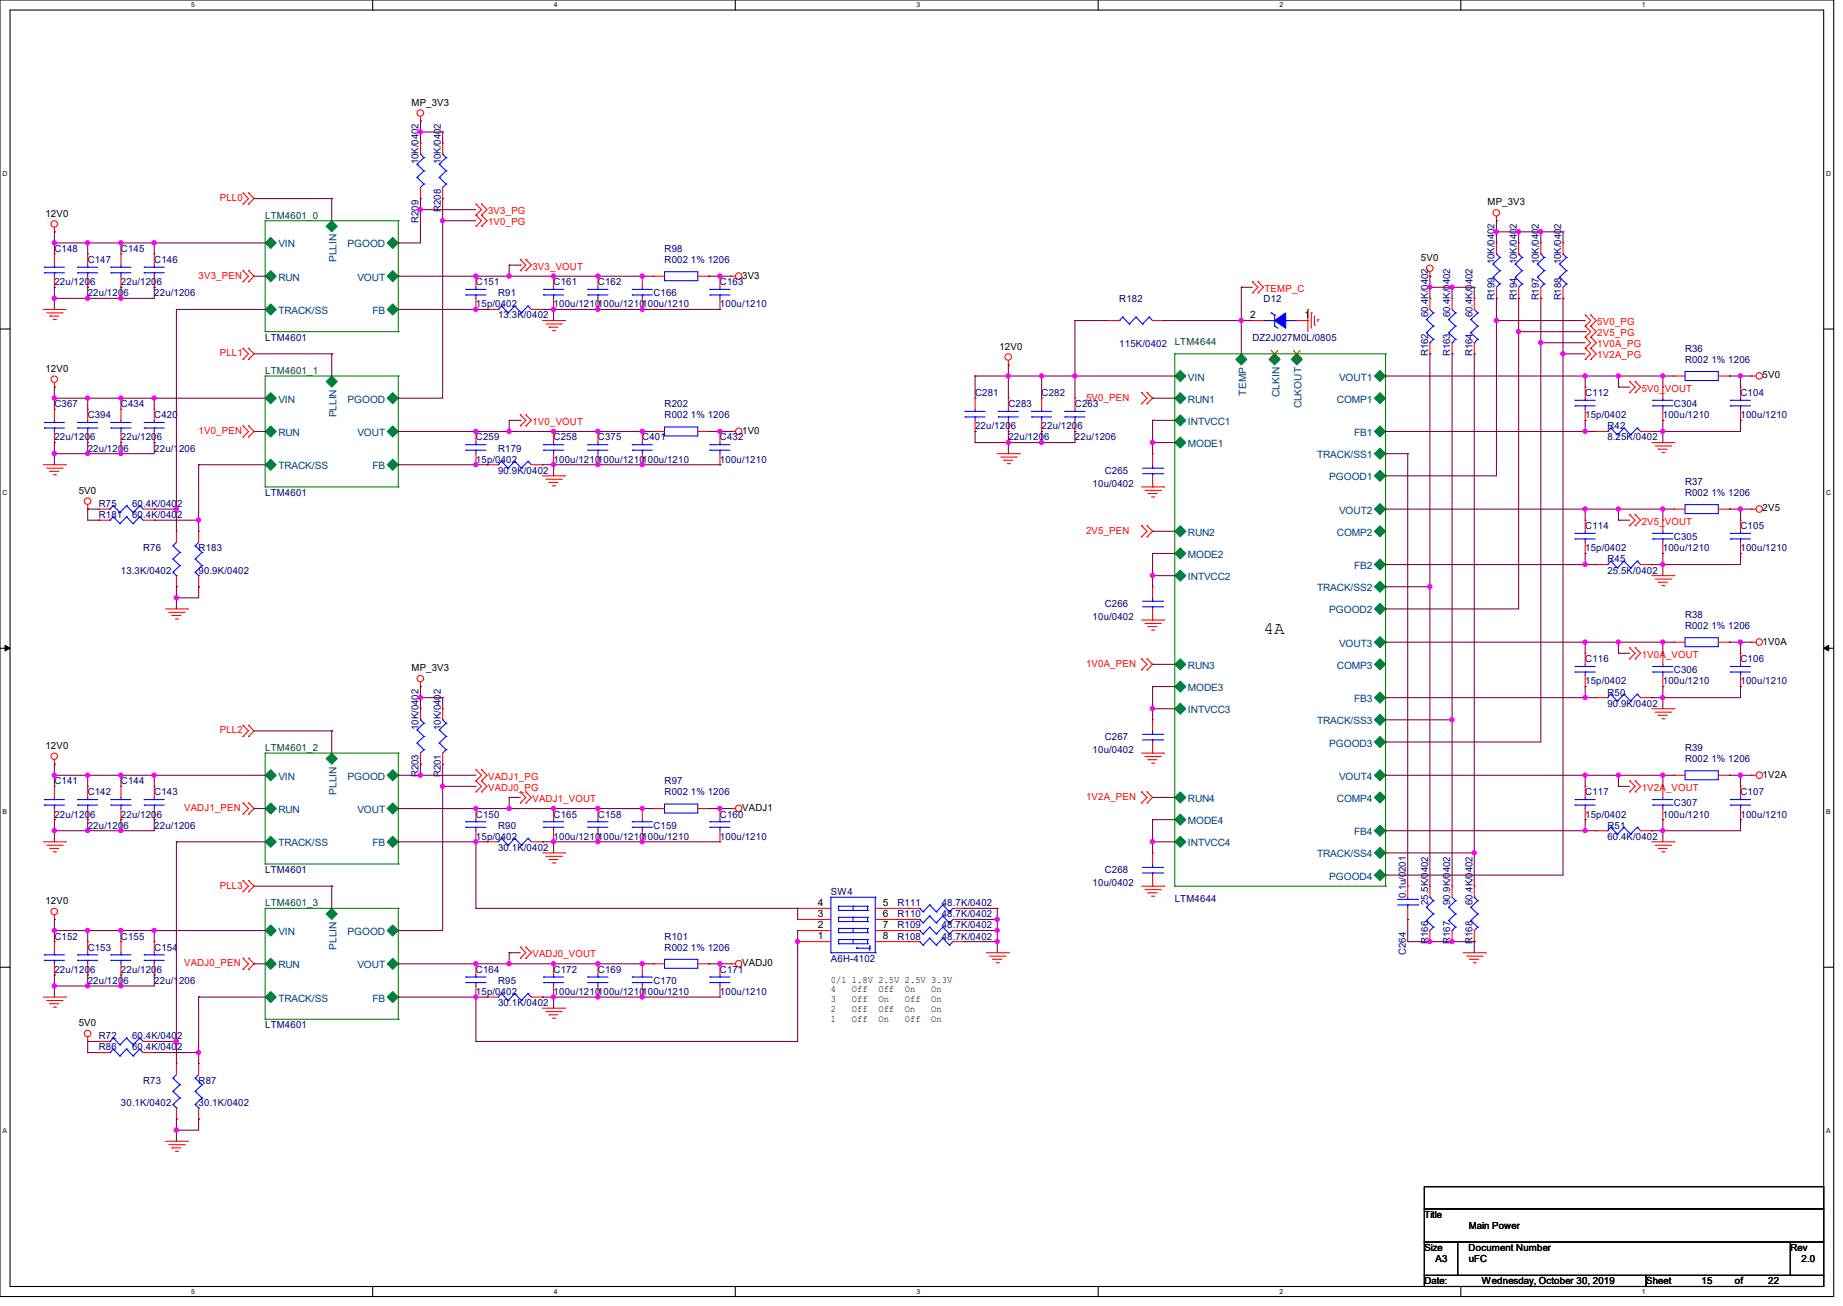
[picture p19: page 15]

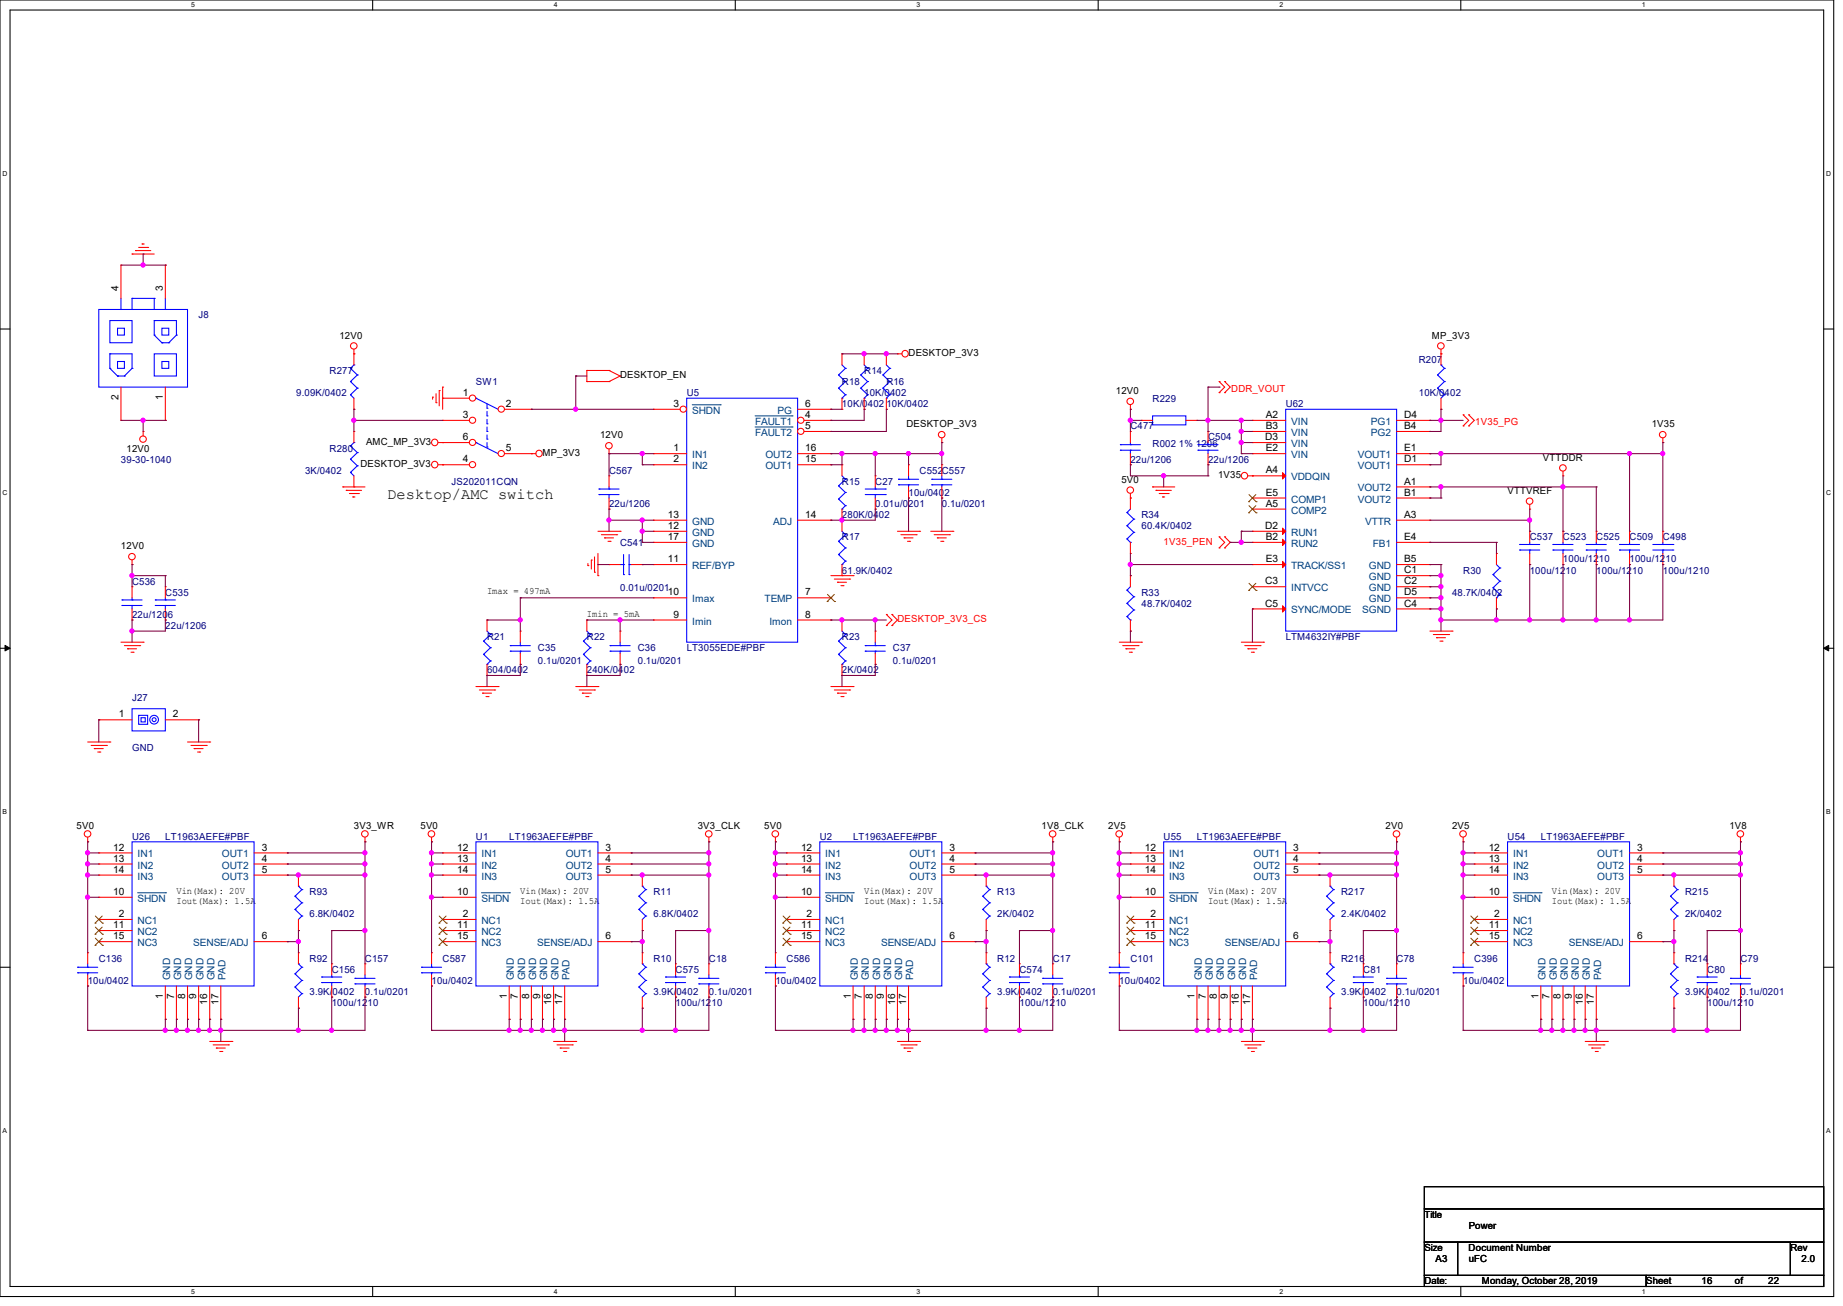
[picture p20: page 16]

9 GND 16 PAD 17 SENSE/ADJ 6 OUT3 5 OUT2 4 OUT1 3 C36

9 GND 16 PAD 17 SENSE/ADJ 6 OUT3 5 OUT2 4 OUT1 3 C37

9 GND 16 PAD 17 SENSE/ADJ 6 OUT3 5 OUT2 4 OUT1 3

9 GND 16 PAD 17 SENSE/ADJ 6 OUT3 5 OUT2 4 OUT1 3 R215

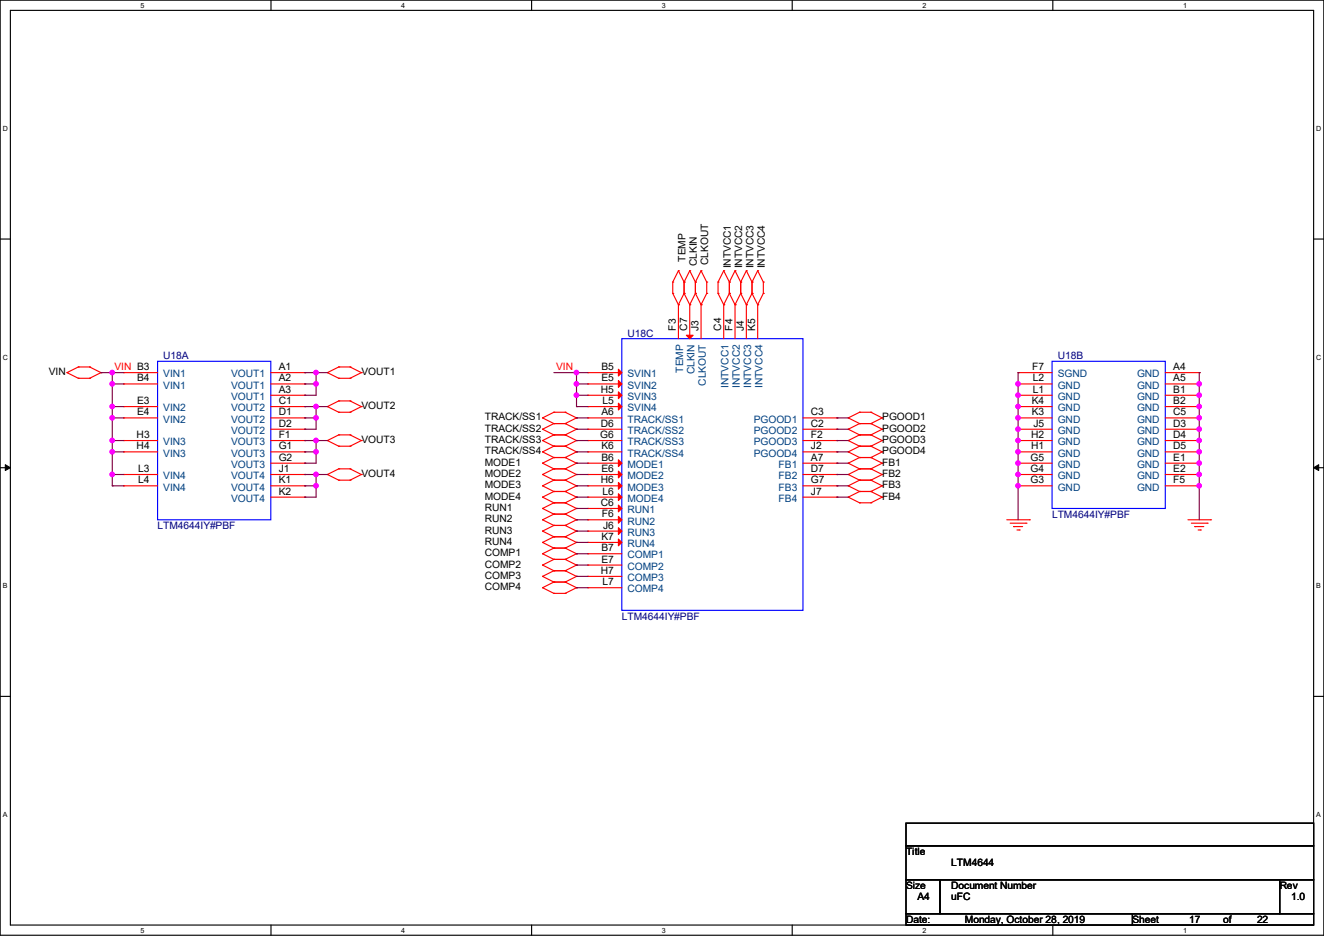
[picture p21: page 17]

VIN | VOUT

U28A

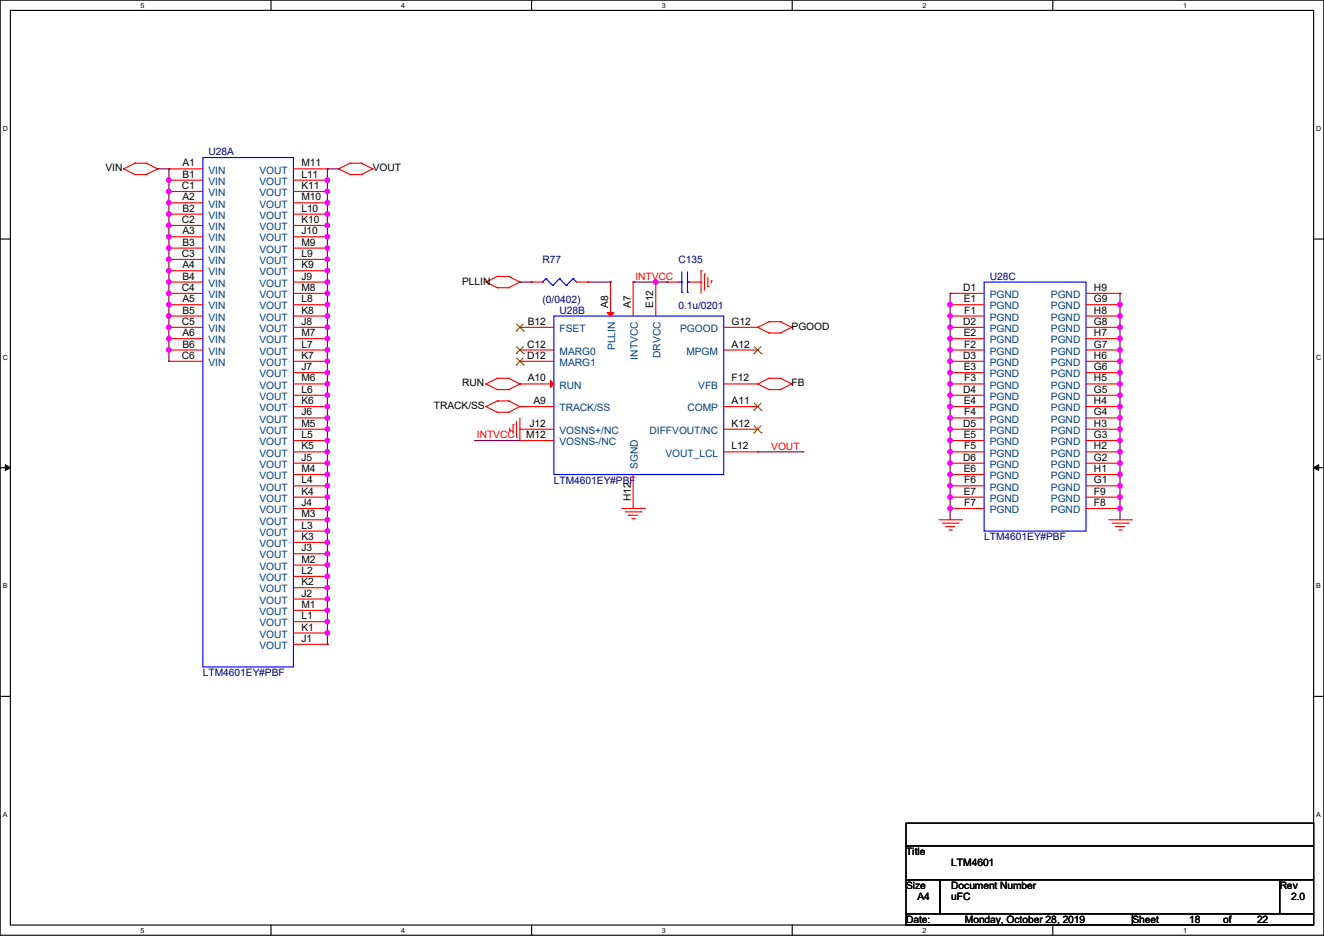
[picture p22: page 18]

VOUT J1 VOUT K1 VOUT L1 VOUT M1 VOUT J2 VOUT K2 VOUT L2 VOUT M2 VOUT J3 VOUT K3 VOUT L3 VOUT M3 VOUT J4 VOUT K4 VOUT L4 VOUT M4 VOUT J5 VOUT K5 VOUT L5 VOUT M5 VOUT J6 VOUT K6 VOUT L6 VOUT M6 VOUT J7 VOUT K7 VOUT L7 VOUT M7 VOUT J8 VOUT K8 VOUT L8 VOUT M8 VOUT J9 VOUT K9 VOUT L9 VOUT M9 VOUT J10 VOUT K10 VOUT L10 VOUT M10 VOUT K11 VOUT L11 VOUT M11

INTVCC
DIFFVOUT/NC K12 DRVCC E¹²

VIN | VOUT

U52A

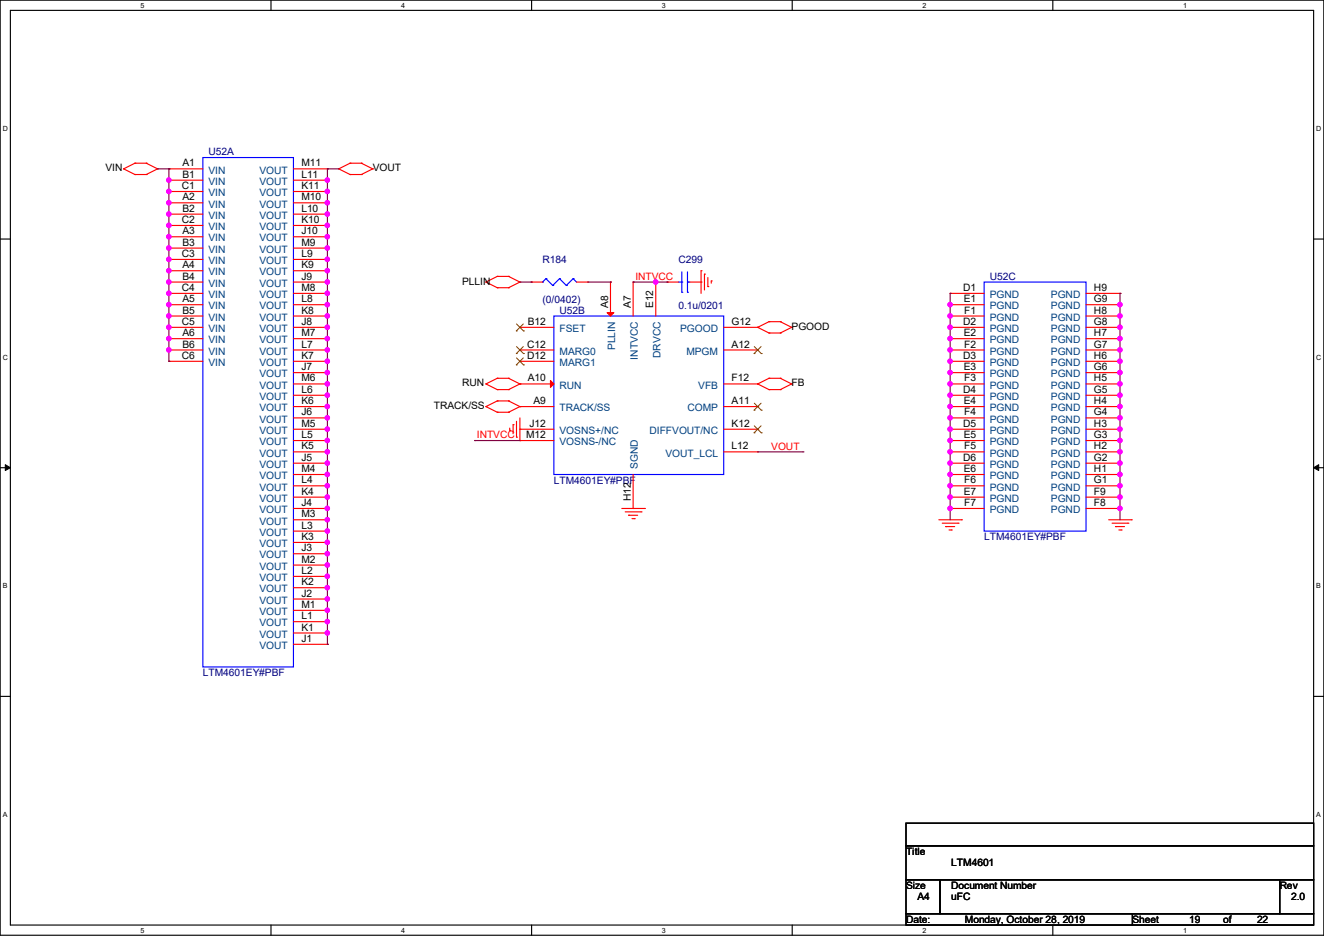
[picture p23: page 19]
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

INTVCC
DIFFVOUT/NC K12 DRVCC E¹²

VIN | VOUT

U27A

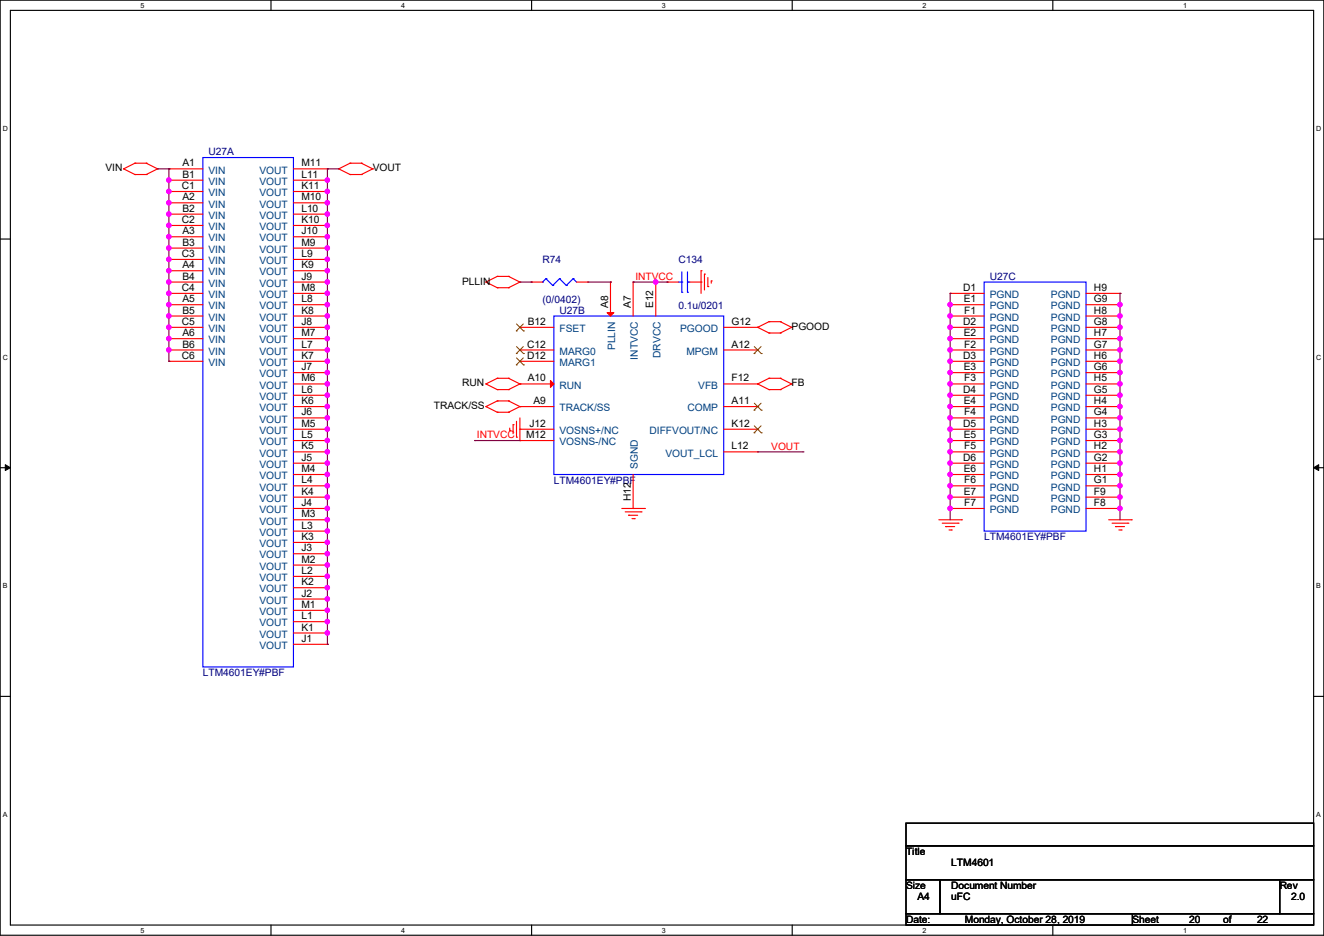
[picture p24: page 20]
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

INTVCC
DIFFVOUT/NC K12 DRVCC E¹²

VIN | VOUT

U30A

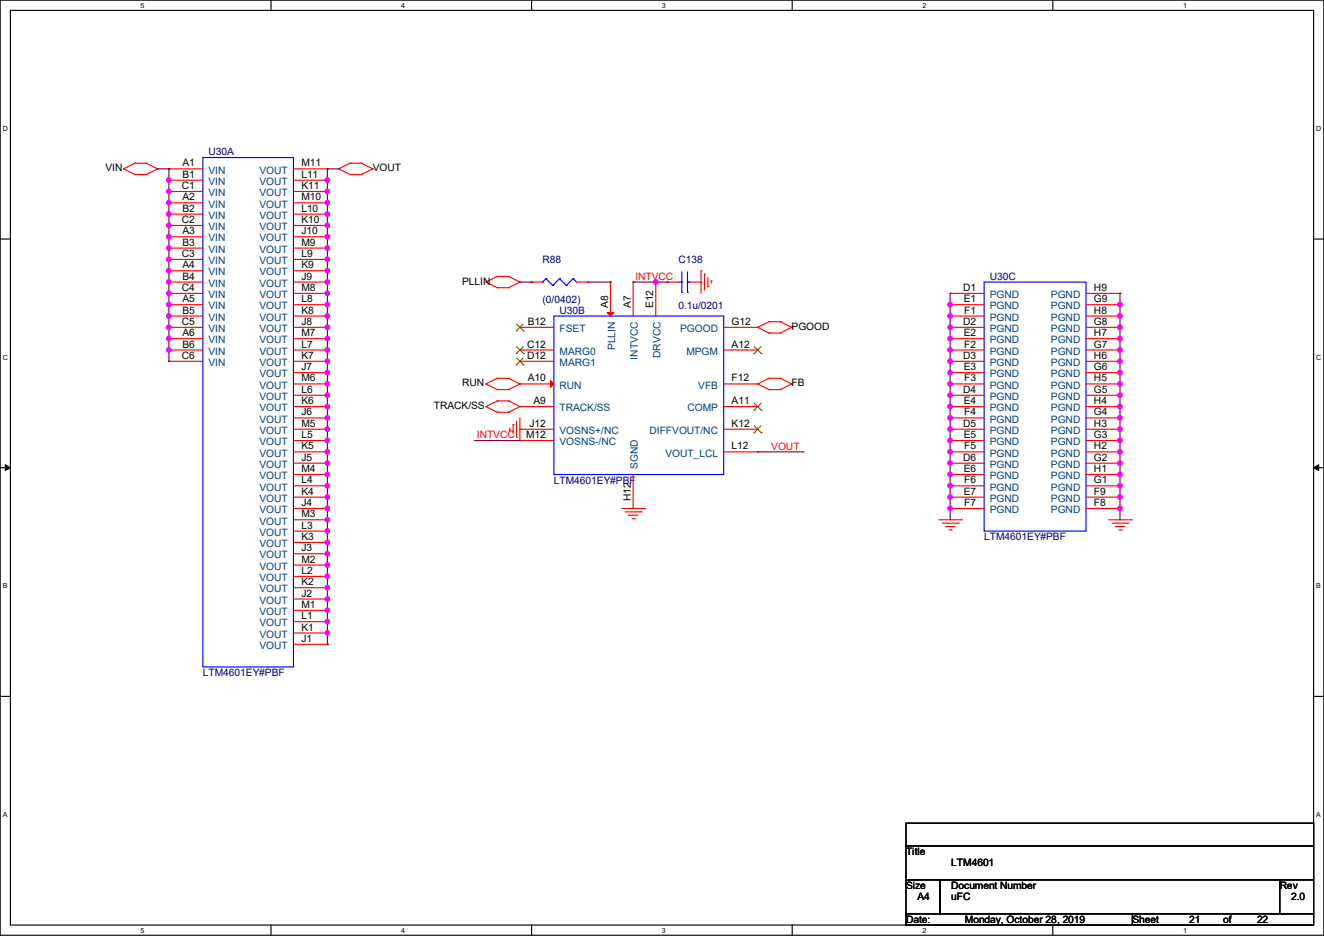
[picture p25: page 21]
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

INTVCC
DIFFVOUT/NC K12 DRVCC E¹²

J15

## SMA-J-P-H-ST-TH1

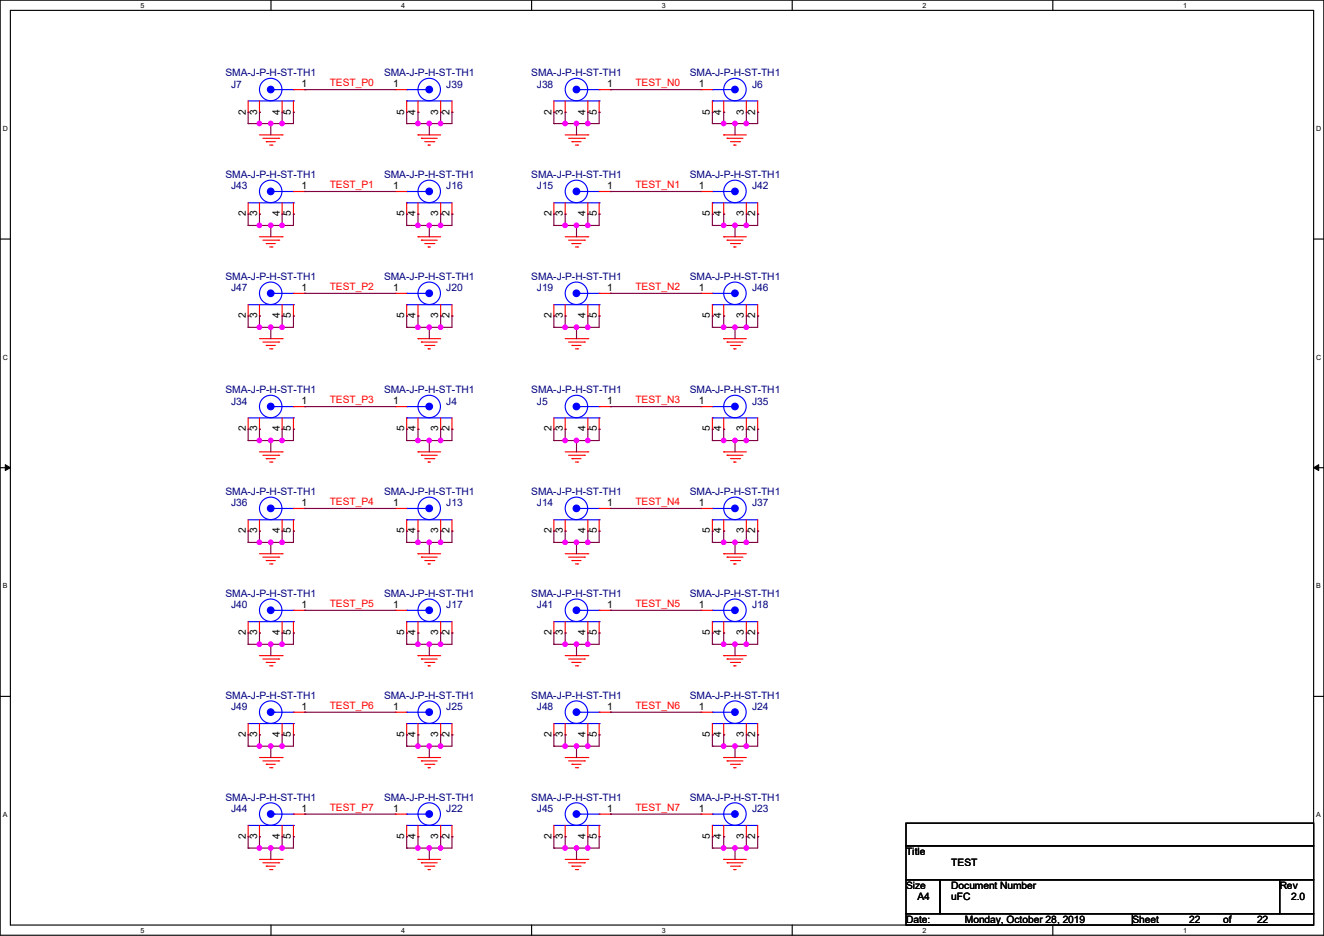
[picture p26: page 22]
