palzhj/uFCv2/template/K7/sitcp/constraints/top.xdc

# uFCv2 xc7k325tffg900-2
set_property  SEVERITY {Warning} [get_drc_checks UCIO-1]
set_property  SEVERITY {Warning} [get_drc_checks NSTD-1]
# DRC: using the GTGREFCLK port on a CPLL
set_property  SEVERITY {Warning} [get_drc_checks {REQP-52}]
set_property  BITSTREAM.CONFIG.SPI_BUSWIDTH 4 [current_design]

# System
set_property  PACKAGE_PIN R23           [get_ports "RST_B"]
set_property  IOSTANDARD  LVCMOS25      [get_ports "RST_B"]

set_property  PACKAGE_PIN T26           [get_ports "REFCLK_P"]
set_property  IOSTANDARD  LVDS_25       [get_ports "REFCLK_P"]
create_clock  -period 5.000   -name REFCLK  [get_ports "REFCLK_P"]
# set_property  PACKAGE_PIN T27           [get_ports "REFCLK_N"]
# set_property  IOSTANDARD  LVDS_25       [get_ports "REFCLK_N"]

set_property  PACKAGE_PIN R28           [get_ports "SRCC_P"]
set_property  IOSTANDARD  LVDS_25       [get_ports "SRCC_P"]
create_clock  -period 6.400   -name OSCCLK  [get_ports "SRCC_P"]
# set_property  PACKAGE_PIN T28           [get_ports "SRCC_N"]
# set_property  IOSTANDARD  LVDS_25       [get_ports "SRCC_N"]

set_property  PACKAGE_PIN AD23          [get_ports "MRCC_P[0]"]
set_property  IOSTANDARD  LVDS_25       [get_ports "MRCC_P[0]"]
create_clock  -period 10.000  -name PLLCLK  [get_ports "MRCC_P[0]"]
# set_property  PACKAGE_PIN AE24          [get_ports "MRCC_N[0]"]
# set_property  IOSTANDARD  LVDS_25       [get_ports "MRCC_N[0]"]

set_property  PACKAGE_PIN AB27          [get_ports "MRCC_P[1]"]
set_property  IOSTANDARD  LVDS_25       [get_ports "MRCC_P[1]"]
create_clock  -period 8.000   -name WRCLK   [get_ports "MRCC_P[1]"]
# set_property  PACKAGE_PIN AC27          [get_ports "MRCC_N[1]"]
# set_property  IOSTANDARD  LVDS_25       [get_ports "MRCC_N[1]"]

set_property  PACKAGE_PIN AG29          [get_ports "MRCC_P[2]"]
set_property  IOSTANDARD  LVDS_25       [get_ports "MRCC_P[2]"]
create_clock  -period 50.000  -name VCXOCLK   [get_ports "MRCC_P[2]"]
# set_property  PACKAGE_PIN AH29          [get_ports "MRCC_N[2]"]
# set_property  IOSTANDARD  LVDS_25       [get_ports "MRCC_N[2]"]

set_property  PACKAGE_PIN C25           [get_ports "MRCC_P[3]"]
set_property  IOSTANDARD  LVDS_25       [get_ports "MRCC_P[3]"]
create_clock  -period 4.000   -name DDRCLK  [get_ports "MRCC_P[3]"]
# set_property  PACKAGE_PIN B25           [get_ports "MRCC_N[3]"]
# set_property  IOSTANDARD  LVDS_25       [get_ports "MRCC_N[3]"]

set_property  PACKAGE_PIN D27           [get_ports "MRCC_P[4]"]
set_property  IOSTANDARD  LVDS_25       [get_ports "MRCC_P[4]"]
# set_property  PACKAGE_PIN C27           [get_ports "MRCC_N[4]"]
# set_property  IOSTANDARD  LVDS_25       [get_ports "MRCC_N[4]"]

set_property  PACKAGE_PIN F20           [get_ports "MRCC_P[5]"]
set_property  IOSTANDARD  LVDS_25       [get_ports "MRCC_P[5]"]
# set_property  PACKAGE_PIN E20           [get_ports "MRCC_N[5]"]
# set_property  IOSTANDARD  LVDS_25       [get_ports "MRCC_N[5]"]

set_property  PACKAGE_PIN D17           [get_ports "MRCC_P[6]"]
set_property  IOSTANDARD  LVDS_25       [get_ports "MRCC_P[6]"]
# set_property  PACKAGE_PIN D18           [get_ports "MRCC_N[6]"]
# set_property  IOSTANDARD  LVDS_25       [get_ports "MRCC_N[6]"]

set_property  PACKAGE_PIN U27           [get_ports "LEMO_CLK_IN_P"]
set_property  IOSTANDARD  LVDS_25       [get_ports "LEMO_CLK_IN_P"]
create_clock  -period 25.00   -name LEMOCLK   [get_ports "LEMO_CLK_IN_P"]
# set_property  PACKAGE_PIN U28           [get_ports "LEMO_CLK_IN_N"]
# set_property  IOSTANDARD  LVDS_25       [get_ports "LEMO_CLK_IN_N"]

# I/O
set_property  PACKAGE_PIN Y28           [get_ports "DIPSW[0]"]
set_property  IOSTANDARD  LVCMOS25      [get_ports "DIPSW[0]"]
set_property  PULLUP      true          [get_ports "DIPSW[0]"]
set_property  PACKAGE_PIN Y26           [get_ports "DIPSW[1]"]
set_property  IOSTANDARD  LVCMOS25      [get_ports "DIPSW[1]"]
set_property  PULLUP      true          [get_ports "DIPSW[1]"]
set_property  PACKAGE_PIN W27           [get_ports "DIPSW[2]"]
set_property  IOSTANDARD  LVCMOS25      [get_ports "DIPSW[2]"]
set_property  PULLUP      true          [get_ports "DIPSW[2]"]
set_property  PACKAGE_PIN AA26          [get_ports "DIPSW[3]"]
set_property  IOSTANDARD  LVCMOS25      [get_ports "DIPSW[3]"]
set_property  PULLUP      true          [get_ports "DIPSW[3]"]
set_property  PACKAGE_PIN Y25           [get_ports "DIPSW[4]"]
set_property  IOSTANDARD  LVCMOS25      [get_ports "DIPSW[4]"]
set_property  PULLUP      true          [get_ports "DIPSW[4]"]
set_property  PACKAGE_PIN AA28          [get_ports "DIPSW[5]"]
set_property  IOSTANDARD  LVCMOS25      [get_ports "DIPSW[5]"]
set_property  PULLUP      true          [get_ports "DIPSW[5]"]
set_property  PACKAGE_PIN AA25          [get_ports "DIPSW[6]"]
set_property  IOSTANDARD  LVCMOS25      [get_ports "DIPSW[6]"]
set_property  PULLUP      true          [get_ports "DIPSW[6]"]
set_property  PACKAGE_PIN W28           [get_ports "DIPSW[7]"]
set_property  IOSTANDARD  LVCMOS25      [get_ports "DIPSW[7]"]
set_property  PULLUP      true          [get_ports "DIPSW[7]"]

set_property  PACKAGE_PIN U30           [get_ports "TESTPIN[0]"]
set_property  IOSTANDARD  LVCMOS25      [get_ports "TESTPIN[0]"]
set_property  PACKAGE_PIN U29           [get_ports "TESTPIN[1]"]
set_property  IOSTANDARD  LVCMOS25      [get_ports "TESTPIN[1]"]
set_property  PACKAGE_PIN V30           [get_ports "TESTPIN[2]"]
set_property  IOSTANDARD  LVCMOS25      [get_ports "TESTPIN[2]"]
set_property  PACKAGE_PIN V29           [get_ports "TESTPIN[3]"]
set_property  IOSTANDARD  LVCMOS25      [get_ports "TESTPIN[3]"]

# RED
set_property  PACKAGE_PIN Y21           [get_ports "SYSLED[0]"]
set_property  IOSTANDARD  LVCMOS25      [get_ports "SYSLED[0]"]
# BLUE
set_property  PACKAGE_PIN Y23           [get_ports "SYSLED[1]"]
set_property  IOSTANDARD  LVCMOS25      [get_ports "SYSLED[1]"]
# GREEN
set_property  PACKAGE_PIN Y24           [get_ports "SYSLED[2]"]
set_property  IOSTANDARD  LVCMOS25      [get_ports "SYSLED[2]"]

set_property  PACKAGE_PIN K18           [get_ports "IO_P[0]"]
set_property  IOSTANDARD  LVDS_25       [get_ports "IO_P[0]"]
set_property  PACKAGE_PIN J18           [get_ports "IO_N[0]"]
set_property  IOSTANDARD  LVDS_25       [get_ports "IO_N[0]"]
set_property  PACKAGE_PIN H20           [get_ports "IO_P[1]"]
set_property  IOSTANDARD  LVDS_25       [get_ports "IO_P[1]"]
set_property  PACKAGE_PIN G20           [get_ports "IO_N[1]"]
set_property  IOSTANDARD  LVDS_25       [get_ports "IO_N[1]"]
set_property  PACKAGE_PIN J17           [get_ports "IO_P[2]"]
set_property  IOSTANDARD  LVDS_25       [get_ports "IO_P[2]"]
set_property  PACKAGE_PIN H17           [get_ports "IO_N[2]"]
set_property  IOSTANDARD  LVDS_25       [get_ports "IO_N[2]"]
set_property  PACKAGE_PIN E23           [get_ports "IO_P[3]"]
set_property  IOSTANDARD  LVDS_25       [get_ports "IO_P[3]"]
set_property  PACKAGE_PIN D23           [get_ports "IO_N[3]"]
set_property  IOSTANDARD  LVDS_25       [get_ports "IO_N[3]"]
set_property  PACKAGE_PIN F25           [get_ports "IO_P[4]"]
set_property  IOSTANDARD  LVDS_25       [get_ports "IO_P[4]"]
set_property  PACKAGE_PIN E25           [get_ports "IO_N[4]"]
set_property  IOSTANDARD  LVDS_25       [get_ports "IO_N[4]"]
set_property  PACKAGE_PIN P29           [get_ports "IO_P[5]"]
set_property  IOSTANDARD  LVDS_25       [get_ports "IO_P[5]"]
set_property  PACKAGE_PIN R29           [get_ports "IO_N[5]"]
set_property  IOSTANDARD  LVDS_25       [get_ports "IO_N[5]"]
set_property  PACKAGE_PIN P27           [get_ports "IO_P[6]"]
set_property  IOSTANDARD  LVDS_25       [get_ports "IO_P[6]"]
set_property  PACKAGE_PIN P28           [get_ports "IO_N[6]"]
set_property  IOSTANDARD  LVDS_25       [get_ports "IO_N[6]"]
set_property  PACKAGE_PIN R30           [get_ports "IO_P[7]"]
set_property  IOSTANDARD  LVDS_25       [get_ports "IO_P[7]"]
set_property  PACKAGE_PIN T30           [get_ports "IO_N[7]"]
set_property  IOSTANDARD  LVDS_25       [get_ports "IO_N[7]"]
set_property  PACKAGE_PIN P26           [get_ports "IO_P[8]"]
set_property  IOSTANDARD  LVDS_25       [get_ports "IO_P[8]"]
set_property  PACKAGE_PIN R26           [get_ports "IO_N[8]"]
set_property  IOSTANDARD  LVDS_25       [get_ports "IO_N[8]"]
set_property  PACKAGE_PIN T25           [get_ports "IO_P[9]"]
set_property  IOSTANDARD  LVDS_25       [get_ports "IO_P[9]"]
set_property  PACKAGE_PIN U25           [get_ports "IO_N[9]"]
set_property  IOSTANDARD  LVDS_25       [get_ports "IO_N[9]"]

# LEMO interface
set_property  PACKAGE_PIN V27           [get_ports "LEMO_IN"]
set_property  IOSTANDARD  LVCMOS25      [get_ports "LEMO_IN"]
set_property  PACKAGE_PIN R19           [get_ports "LEMO_INOUT[0]"]
set_property  IOSTANDARD  LVCMOS25      [get_ports "LEMO_INOUT[0]"]
set_property  PACKAGE_PIN U20           [get_ports "LEMO_INOUT[1]"]
set_property  IOSTANDARD  LVCMOS25      [get_ports "LEMO_INOUT[1]"]
set_property  PACKAGE_PIN W19           [get_ports "LEMO_INOUT_DE[0]"]
set_property  IOSTANDARD  LVCMOS25      [get_ports "LEMO_INOUT_DE[0]"]
set_property  PACKAGE_PIN R24           [get_ports "LEMO_INOUT_DE[1]"]
set_property  IOSTANDARD  LVCMOS25      [get_ports "LEMO_INOUT_DE[1]"]

# IIC
set_property  PACKAGE_PIN V21           [get_ports "FPGA_SCL"]
set_property  IOSTANDARD  LVCMOS25      [get_ports "FPGA_SCL"]
set_property  PACKAGE_PIN V22           [get_ports "FPGA_SDA"]
set_property  IOSTANDARD  LVCMOS25      [get_ports "FPGA_SDA"]

# FLASH Interface
# set_property  PACKAGE_PIN P24           [get_ports "FLASH_D[0]"]
# set_property  IOSTANDARD  LVCMOS25      [get_ports "FLASH_D[0]"]
# set_property  PACKAGE_PIN R25           [get_ports "FLASH_D[1]"]
# set_property  IOSTANDARD  LVCMOS25      [get_ports "FLASH_D[1]"]
# set_property  PACKAGE_PIN R20           [get_ports "FLASH_D[2]"]
# set_property  IOSTANDARD  LVCMOS25      [get_ports "FLASH_D[2]"]
# set_property  PACKAGE_PIN R21           [get_ports "FLASH_D[3]"]
# set_property  IOSTANDARD  LVCMOS25      [get_ports "FLASH_D[3]"]
# set_property  PACKAGE_PIN U19           [get_ports "FLASH_CS_B"]
# set_property  IOSTANDARD  LVCMOS25      [get_ports "FLASH_CS_B"]

# WR_DAC
set_property  PACKAGE_PIN AA11          [get_ports "DAC_CLK"]
set_property  IOSTANDARD  SSTL135       [get_ports "DAC_CLK"]
set_property  PACKAGE_PIN AA10          [get_ports "DAC_MOSI"]
set_property  IOSTANDARD  SSTL135       [get_ports "DAC_MOSI"]
set_property  PACKAGE_PIN Y10           [get_ports "DAC_NCS[0]"]
set_property  IOSTANDARD  SSTL135       [get_ports "DAC_NCS[0]"]
set_property  PACKAGE_PIN Y11           [get_ports "DAC_NCS[1]"]
set_property  IOSTANDARD  SSTL135       [get_ports "DAC_NCS[1]"]

# FMC0
set_property  PACKAGE_PIN B23           [get_ports "FMC0_PRSNT_B"]
set_property  IOSTANDARD  LVCMOS25      [get_ports "FMC0_PRSNT_B"]

set_property  PACKAGE_PIN E28           [get_ports "FMC0_LA_P[0]"]
set_property  IOSTANDARD  LVDS_25       [get_ports "FMC0_LA_P[0]"]
set_property  PACKAGE_PIN D28           [get_ports "FMC0_LA_N[0]"]
set_property  IOSTANDARD  LVDS_25       [get_ports "FMC0_LA_N[0]"]
set_property  PACKAGE_PIN D26           [get_ports "FMC0_LA_P[1]"]
set_property  IOSTANDARD  LVDS_25       [get_ports "FMC0_LA_P[1]"]
set_property  PACKAGE_PIN C26           [get_ports "FMC0_LA_N[1]"]
set_property  IOSTANDARD  LVDS_25       [get_ports "FMC0_LA_N[1]"]
set_property  PACKAGE_PIN H30           [get_ports "FMC0_LA_P[2]"]
set_property  IOSTANDARD  LVDS_25       [get_ports "FMC0_LA_P[2]"]
set_property  PACKAGE_PIN G30           [get_ports "FMC0_LA_N[2]"]
set_property  IOSTANDARD  LVDS_25       [get_ports "FMC0_LA_N[2]"]
set_property  PACKAGE_PIN G29           [get_ports "FMC0_LA_P[3]"]
set_property  IOSTANDARD  LVDS_25       [get_ports "FMC0_LA_P[3]"]
set_property  PACKAGE_PIN F30           [get_ports "FMC0_LA_N[3]"]
set_property  IOSTANDARD  LVDS_25       [get_ports "FMC0_LA_N[3]"]
set_property  PACKAGE_PIN E29           [get_ports "FMC0_LA_P[4]"]
set_property  IOSTANDARD  LVDS_25       [get_ports "FMC0_LA_P[4]"]
set_property  PACKAGE_PIN E30           [get_ports "FMC0_LA_N[4]"]
set_property  IOSTANDARD  LVDS_25       [get_ports "FMC0_LA_N[4]"]
set_property  PACKAGE_PIN G28           [get_ports "FMC0_LA_P[5]"]
set_property  IOSTANDARD  LVDS_25       [get_ports "FMC0_LA_P[5]"]
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
set_property  PACKAGE_PIN C12           [get_ports "FMC0_HA_P[20]"]
set_property  IOSTANDARD  LVDS_25       [get_ports "FMC0_HA_P[20]"]
set_property  PACKAGE_PIN B12           [get_ports "FMC0_HA_N[20]"]
set_property  IOSTANDARD  LVDS_25       [get_ports "FMC0_HA_N[20]"]
set_property  PACKAGE_PIN B14           [get_ports "FMC0_HA_P[21]"]
set_property  IOSTANDARD  LVDS_25       [get_ports "FMC0_HA_P[21]"]
set_property  PACKAGE_PIN A15           [get_ports "FMC0_HA_N[21]"]
set_property  IOSTANDARD  LVDS_25       [get_ports "FMC0_HA_N[21]"]
set_property  PACKAGE_PIN B13           [get_ports "FMC0_HA_P[22]"]
set_property  IOSTANDARD  LVDS_25       [get_ports "FMC0_HA_P[22]"]
set_property  PACKAGE_PIN A13           [get_ports "FMC0_HA_N[22]"]
set_property  IOSTANDARD  LVDS_25       [get_ports "FMC0_HA_N[22]"]
set_property  PACKAGE_PIN A11           [get_ports "FMC0_HA_P[23]"]
set_property  IOSTANDARD  LVDS_25       [get_ports "FMC0_HA_P[23]"]
set_property  PACKAGE_PIN A12           [get_ports "FMC0_HA_N[23]"]
set_property  IOSTANDARD  LVDS_25       [get_ports "FMC0_HA_N[23]"]

set_property  PACKAGE_PIN D2            [get_ports "FMC0_DP_C2M_P[0]"]
set_property  PACKAGE_PIN C4            [get_ports "FMC0_DP_C2M_P[1]"]
set_property  PACKAGE_PIN B2            [get_ports "FMC0_DP_C2M_P[2]"]
set_property  PACKAGE_PIN A4            [get_ports "FMC0_DP_C2M_P[3]"]

set_property  PACKAGE_PIN E4            [get_ports "FMC0_DP_M2C_P[0]"]
set_property  PACKAGE_PIN D6            [get_ports "FMC0_DP_M2C_P[1]"]
set_property  PACKAGE_PIN B6            [get_ports "FMC0_DP_M2C_P[2]"]
set_property  PACKAGE_PIN A8            [get_ports "FMC0_DP_M2C_P[3]"]

set_property  PACKAGE_PIN C8            [get_ports "MGTCLK118_P0"]
set_property  PACKAGE_PIN E8            [get_ports "MGTCLK118_P1"]

# FMC1
set_property  PACKAGE_PIN A23           [get_ports "FMC1_PRSNT_B"]
set_property  IOSTANDARD  LVCMOS25      [get_ports "FMC1_PRSNT_B"]

set_property  PACKAGE_PIN AG24          [get_ports "FMC1_LA_P[0]"]
set_property  IOSTANDARD  LVDS_25       [get_ports "FMC1_LA_P[0]"]
set_property  PACKAGE_PIN AH24          [get_ports "FMC1_LA_N[0]"]
set_property  IOSTANDARD  LVDS_25       [get_ports "FMC1_LA_N[0]"]
set_property  PACKAGE_PIN AE23          [get_ports "FMC1_LA_P[1]"]
set_property  IOSTANDARD  LVDS_25       [get_ports "FMC1_LA_P[1]"]
set_property  PACKAGE_PIN AF23          [get_ports "FMC1_LA_N[1]"]
set_property  IOSTANDARD  LVDS_25       [get_ports "FMC1_LA_N[1]"]
set_property  PACKAGE_PIN AG20          [get_ports "FMC1_LA_P[2]"]
set_property  IOSTANDARD  LVDS_25       [get_ports "FMC1_LA_P[2]"]
set_property  PACKAGE_PIN AH20          [get_ports "FMC1_LA_N[2]"]
set_property  IOSTANDARD  LVDS_25       [get_ports "FMC1_LA_N[2]"]
set_property  PACKAGE_PIN AC20          [get_ports "FMC1_LA_P[3]"]
set_property  IOSTANDARD  LVDS_25       [get_ports "FMC1_LA_P[3]"]
set_property  PACKAGE_PIN AC21          [get_ports "FMC1_LA_N[3]"]
set_property  IOSTANDARD  LVDS_25       [get_ports "FMC1_LA_N[3]"]
set_property  PACKAGE_PIN AH21          [get_ports "FMC1_LA_P[4]"]
set_property  IOSTANDARD  LVDS_25       [get_ports "FMC1_LA_P[4]"]
set_property  PACKAGE_PIN AJ21          [get_ports "FMC1_LA_N[4]"]
set_property  IOSTANDARD  LVDS_25       [get_ports "FMC1_LA_N[4]"]
set_property  PACKAGE_PIN AG22          [get_ports "FMC1_LA_P[5]"]
set_property  IOSTANDARD  LVDS_25       [get_ports "FMC1_LA_P[5]"]
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
set_property  PACKAGE_PIN L21           [get_ports "FMC1_HA_P[20]"]
set_property  IOSTANDARD  LVDS_25       [get_ports "FMC1_HA_P[20]"]
set_property  PACKAGE_PIN K21           [get_ports "FMC1_HA_N[20]"]
set_property  IOSTANDARD  LVDS_25       [get_ports "FMC1_HA_N[20]"]
set_property  PACKAGE_PIN K26           [get_ports "FMC1_HA_P[21]"]
set_property  IOSTANDARD  LVDS_25       [get_ports "FMC1_HA_P[21]"]
set_property  PACKAGE_PIN J26           [get_ports "FMC1_HA_N[21]"]
set_property  IOSTANDARD  LVDS_25       [get_ports "FMC1_HA_N[21]"]
set_property  PACKAGE_PIN J23           [get_ports "FMC1_HA_P[22]"]
set_property  IOSTANDARD  LVDS_25       [get_ports "FMC1_HA_P[22]"]
set_property  PACKAGE_PIN J24           [get_ports "FMC1_HA_N[22]"]
set_property  IOSTANDARD  LVDS_25       [get_ports "FMC1_HA_N[22]"]
set_property  PACKAGE_PIN J21           [get_ports "FMC1_HA_P[23]"]
set_property  IOSTANDARD  LVDS_25       [get_ports "FMC1_HA_P[23]"]
set_property  PACKAGE_PIN J22           [get_ports "FMC1_HA_N[23]"]
set_property  IOSTANDARD  LVDS_25       [get_ports "FMC1_HA_N[23]"]

set_property  PACKAGE_PIN P2            [get_ports "FMC1_DP_C2M_P[0]"]
set_property  PACKAGE_PIN N4            [get_ports "FMC1_DP_C2M_P[1]"]
set_property  PACKAGE_PIN M2            [get_ports "FMC1_DP_C2M_P[2]"]
set_property  PACKAGE_PIN L4            [get_ports "FMC1_DP_C2M_P[3]"]

set_property  PACKAGE_PIN T6            [get_ports "FMC1_DP_M2C_P[0]"]
set_property  PACKAGE_PIN R4            [get_ports "FMC1_DP_M2C_P[1]"]
set_property  PACKAGE_PIN P6            [get_ports "FMC1_DP_M2C_P[2]"]
set_property  PACKAGE_PIN M6            [get_ports "FMC1_DP_M2C_P[3]"]

set_property  PACKAGE_PIN L8            [get_ports "MGTCLK116_P0"]
set_property  PACKAGE_PIN N8            [get_ports "MGTCLK116_P1"]

# DDR3
set_property  PACKAGE_PIN AD12          [get_ports "DDR3_CLK_P[0]"]
set_property  IOSTANDARD  DIFF_SSTL135  [get_ports "DDR3_CLK_P[0]"]
set_property  VCCAUX_IO   HIGH          [get_ports "DDR3_CLK_P[0]"]
set_property  SLEW        FAST          [get_ports "DDR3_CLK_P[0]"]
set_property  PACKAGE_PIN AD11          [get_ports "DDR3_CLK_N[0]"]
set_property  IOSTANDARD  DIFF_SSTL135  [get_ports "DDR3_CLK_N[0]"]
set_property  VCCAUX_IO   HIGH          [get_ports "DDR3_CLK_N[0]"]
set_property  SLEW        FAST          [get_ports "DDR3_CLK_N[0]"]
set_property  PACKAGE_PIN AE11          [get_ports "DDR3_CLK_P[1]"]
set_property  IOSTANDARD  DIFF_SSTL135  [get_ports "DDR3_CLK_P[1]"]
set_property  VCCAUX_IO   HIGH          [get_ports "DDR3_CLK_P[1]"]
set_property  SLEW        FAST          [get_ports "DDR3_CLK_P[1]"]
set_property  PACKAGE_PIN AF11          [get_ports "DDR3_CLK_N[1]"]
set_property  IOSTANDARD  DIFF_SSTL135  [get_ports "DDR3_CLK_N[1]"]
set_property  VCCAUX_IO   HIGH          [get_ports "DDR3_CLK_N[1]"]
set_property  SLEW        FAST          [get_ports "DDR3_CLK_N[1]"]
set_property  PACKAGE_PIN AC12          [get_ports "DDR3_CKE[0]"]
set_property  IOSTANDARD  SSTL135       [get_ports "DDR3_CKE[0]"]
set_property  VCCAUX_IO   HIGH          [get_ports "DDR3_CKE[0]"]
set_property  SLEW        FAST          [get_ports "DDR3_CKE[0]"]
set_property  PACKAGE_PIN AC10          [get_ports "DDR3_CKE[1]"]
set_property  IOSTANDARD  SSTL135       [get_ports "DDR3_CKE[1]"]
set_property  VCCAUX_IO   HIGH          [get_ports "DDR3_CKE[1]"]
set_property  SLEW        FAST          [get_ports "DDR3_CKE[1]"]
set_property  PACKAGE_PIN AH9           [get_ports "DDR3_S[0]"]
set_property  IOSTANDARD  SSTL135       [get_ports "DDR3_S[0]"]
set_property  VCCAUX_IO   HIGH          [get_ports "DDR3_S[0]"]
set_property  SLEW        FAST          [get_ports "DDR3_S[0]"]
set_property  PACKAGE_PIN AD8           [get_ports "DDR3_S[1]"]
set_property  IOSTANDARD  SSTL135       [get_ports "DDR3_S[1]"]
set_property  VCCAUX_IO   HIGH          [get_ports "DDR3_S[1]"]
set_property  SLEW        FAST          [get_ports "DDR3_S[1]"]
set_property  PACKAGE_PIN AE10          [get_ports "DDR3_ODT[0]"]
set_property  IOSTANDARD  SSTL135       [get_ports "DDR3_ODT[0]"]
set_property  VCCAUX_IO   HIGH          [get_ports "DDR3_ODT[0]"]
set_property  SLEW        FAST          [get_ports "DDR3_ODT[0]"]
set_property  PACKAGE_PIN AE8           [get_ports "DDR3_ODT[1]"]
set_property  IOSTANDARD  SSTL135       [get_ports "DDR3_ODT[1]"]
set_property  VCCAUX_IO   HIGH          [get_ports "DDR3_ODT[1]"]
set_property  SLEW        FAST          [get_ports "DDR3_ODT[1]"]
set_property  PACKAGE_PIN AB10          [get_ports "DDR3_ADDR[15]"]
set_property  IOSTANDARD  SSTL135       [get_ports "DDR3_ADDR[15]"]
set_property  VCCAUX_IO   HIGH          [get_ports "DDR3_ADDR[15]"]
set_property  SLEW        FAST          [get_ports "DDR3_ADDR[15]"]
set_property  PACKAGE_PIN AE13          [get_ports "DDR3_ADDR[14]"]
set_property  IOSTANDARD  SSTL135       [get_ports "DDR3_ADDR[14]"]
set_property  VCCAUX_IO   HIGH          [get_ports "DDR3_ADDR[14]"]
set_property  SLEW        FAST          [get_ports "DDR3_ADDR[14]"]
set_property  PACKAGE_PIN AF12          [get_ports "DDR3_ADDR[13]"]
set_property  IOSTANDARD  SSTL135       [get_ports "DDR3_ADDR[13]"]
set_property  VCCAUX_IO   HIGH          [get_ports "DDR3_ADDR[13]"]
set_property  SLEW        FAST          [get_ports "DDR3_ADDR[13]"]
set_property  PACKAGE_PIN AK14          [get_ports "DDR3_ADDR[12]"]
set_property  IOSTANDARD  SSTL135       [get_ports "DDR3_ADDR[12]"]
set_property  VCCAUX_IO   HIGH          [get_ports "DDR3_ADDR[12]"]
set_property  SLEW        FAST          [get_ports "DDR3_ADDR[12]"]
set_property  PACKAGE_PIN AH14          [get_ports "DDR3_ADDR[11]"]
set_property  IOSTANDARD  SSTL135       [get_ports "DDR3_ADDR[11]"]
set_property  VCCAUX_IO   HIGH          [get_ports "DDR3_ADDR[11]"]
set_property  SLEW        FAST          [get_ports "DDR3_ADDR[11]"]
set_property  PACKAGE_PIN AH11          [get_ports "DDR3_ADDR[10]"]
set_property  IOSTANDARD  SSTL135       [get_ports "DDR3_ADDR[10]"]
set_property  VCCAUX_IO   HIGH          [get_ports "DDR3_ADDR[10]"]
set_property  SLEW        FAST          [get_ports "DDR3_ADDR[10]"]
set_property  PACKAGE_PIN AJ14          [get_ports "DDR3_ADDR[9]"]
set_property  IOSTANDARD  SSTL135       [get_ports "DDR3_ADDR[9]"]
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
set_property  IOSTANDARD  SSTL135       [get_ports "DDR3_DM[3]"]
set_property  VCCAUX_IO   HIGH          [get_ports "DDR3_DM[3]"]
set_property  SLEW        FAST          [get_ports "DDR3_DM[3]"]
set_property  PACKAGE_PIN AJ6           [get_ports "DDR3_DM[4]"]
set_property  IOSTANDARD  SSTL135       [get_ports "DDR3_DM[4]"]
set_property  VCCAUX_IO   HIGH          [get_ports "DDR3_DM[4]"]
set_property  SLEW        FAST          [get_ports "DDR3_DM[4]"]
set_property  PACKAGE_PIN AJ2           [get_ports "DDR3_DM[5]"]
set_property  IOSTANDARD  SSTL135       [get_ports "DDR3_DM[5]"]
set_property  VCCAUX_IO   HIGH          [get_ports "DDR3_DM[5]"]
set_property  SLEW        FAST          [get_ports "DDR3_DM[5]"]
set_property  PACKAGE_PIN AF5           [get_ports "DDR3_DM[6]"]
set_property  IOSTANDARD  SSTL135       [get_ports "DDR3_DM[6]"]
set_property  VCCAUX_IO   HIGH          [get_ports "DDR3_DM[6]"]
set_property  SLEW        FAST          [get_ports "DDR3_DM[6]"]
set_property  PACKAGE_PIN AD4           [get_ports "DDR3_DM[7]"]
set_property  IOSTANDARD  SSTL135       [get_ports "DDR3_DM[7]"]
set_property  VCCAUX_IO   HIGH          [get_ports "DDR3_DM[7]"]
set_property  SLEW        FAST          [get_ports "DDR3_DM[7]"]
set_property  PACKAGE_PIN AC16          [get_ports "DDR3_DQS_P[0]"]
set_property  IOSTANDARD  DIFF_SSTL135_T_DCI  [get_ports "DDR3_DQS_P[0]"]
set_property  VCCAUX_IO   HIGH          [get_ports "DDR3_DQS_P[0]"]
set_property  SLEW        FAST          [get_ports "DDR3_DQS_P[0]"]
set_property  PACKAGE_PIN AC15          [get_ports "DDR3_DQS_N[0]"]
set_property  IOSTANDARD  DIFF_SSTL135_T_DCI  [get_ports "DDR3_DQS_N[0]"]
set_property  VCCAUX_IO   HIGH          [get_ports "DDR3_DQS_N[0]"]
set_property  SLEW        FAST          [get_ports "DDR3_DQS_N[0]"]
set_property  PACKAGE_PIN Y19           [get_ports "DDR3_DQS_P[1]"]
set_property  IOSTANDARD  DIFF_SSTL135_T_DCI  [get_ports "DDR3_DQS_P[1]"]
set_property  VCCAUX_IO   HIGH          [get_ports "DDR3_DQS_P[1]"]
set_property  SLEW        FAST          [get_ports "DDR3_DQS_P[1]"]
set_property  PACKAGE_PIN Y18           [get_ports "DDR3_DQS_N[1]"]
set_property  IOSTANDARD  DIFF_SSTL135_T_DCI  [get_ports "DDR3_DQS_N[1]"]
set_property  VCCAUX_IO   HIGH          [get_ports "DDR3_DQS_N[1]"]
set_property  SLEW        FAST          [get_ports "DDR3_DQS_N[1]"]
set_property  PACKAGE_PIN AJ18          [get_ports "DDR3_DQS_P[2]"]
set_property  IOSTANDARD  DIFF_SSTL135_T_DCI  [get_ports "DDR3_DQS_P[2]"]
set_property  VCCAUX_IO   HIGH          [get_ports "DDR3_DQS_P[2]"]
set_property  SLEW        FAST          [get_ports "DDR3_DQS_P[2]"]
set_property  PACKAGE_PIN AK18          [get_ports "DDR3_DQS_N[2]"]
set_property  IOSTANDARD  DIFF_SSTL135_T_DCI  [get_ports "DDR3_DQS_N[2]"]
set_property  VCCAUX_IO   HIGH          [get_ports "DDR3_DQS_N[2]"]
set_property  SLEW        FAST          [get_ports "DDR3_DQS_N[2]"]
set_property  PACKAGE_PIN AH16          [get_ports "DDR3_DQS_P[3]"]
set_property  IOSTANDARD  DIFF_SSTL135_T_DCI  [get_ports "DDR3_DQS_P[3]"]
set_property  VCCAUX_IO   HIGH          [get_ports "DDR3_DQS_P[3]"]
set_property  SLEW        FAST          [get_ports "DDR3_DQS_P[3]"]
set_property  PACKAGE_PIN AJ16          [get_ports "DDR3_DQS_N[3]"]
set_property  IOSTANDARD  DIFF_SSTL135_T_DCI  [get_ports "DDR3_DQS_N[3]"]
set_property  VCCAUX_IO   HIGH          [get_ports "DDR3_DQS_N[3]"]
set_property  SLEW        FAST          [get_ports "DDR3_DQS_N[3]"]
set_property  PACKAGE_PIN AH7           [get_ports "DDR3_DQS_P[4]"]
set_property  IOSTANDARD  DIFF_SSTL135_T_DCI  [get_ports "DDR3_DQS_P[4]"]
set_property  VCCAUX_IO   HIGH          [get_ports "DDR3_DQS_P[4]"]
set_property  SLEW        FAST          [get_ports "DDR3_DQS_P[4]"]
set_property  PACKAGE_PIN AJ7           [get_ports "DDR3_DQS_N[4]"]
set_property  IOSTANDARD  DIFF_SSTL135_T_DCI  [get_ports "DDR3_DQS_N[4]"]
set_property  VCCAUX_IO   HIGH          [get_ports "DDR3_DQS_N[4]"]
set_property  SLEW        FAST          [get_ports "DDR3_DQS_N[4]"]
set_property  PACKAGE_PIN AG2           [get_ports "DDR3_DQS_P[5]"]
set_property  IOSTANDARD  DIFF_SSTL135_T_DCI  [get_ports "DDR3_DQS_P[5]"]
set_property  VCCAUX_IO   HIGH          [get_ports "DDR3_DQS_P[5]"]
set_property  SLEW        FAST          [get_ports "DDR3_DQS_P[5]"]
set_property  PACKAGE_PIN AH1           [get_ports "DDR3_DQS_N[5]"]
set_property  IOSTANDARD  DIFF_SSTL135_T_DCI  [get_ports "DDR3_DQS_N[5]"]
set_property  VCCAUX_IO   HIGH          [get_ports "DDR3_DQS_N[5]"]
set_property  SLEW        FAST          [get_ports "DDR3_DQS_N[5]"]
set_property  PACKAGE_PIN AG4           [get_ports "DDR3_DQS_P[6]"]
set_property  IOSTANDARD  DIFF_SSTL135_T_DCI  [get_ports "DDR3_DQS_P[6]"]
set_property  VCCAUX_IO   HIGH          [get_ports "DDR3_DQS_P[6]"]
set_property  SLEW        FAST          [get_ports "DDR3_DQS_P[6]"]
set_property  PACKAGE_PIN AG3           [get_ports "DDR3_DQS_N[6]"]
set_property  IOSTANDARD  DIFF_SSTL135_T_DCI  [get_ports "DDR3_DQS_N[6]"]
set_property  VCCAUX_IO   HIGH          [get_ports "DDR3_DQS_N[6]"]
set_property  SLEW        FAST          [get_ports "DDR3_DQS_N[6]"]
set_property  PACKAGE_PIN AD2           [get_ports "DDR3_DQS_P[7]"]
set_property  IOSTANDARD  DIFF_SSTL135_T_DCI  [get_ports "DDR3_DQS_P[7]"]
set_property  VCCAUX_IO   HIGH          [get_ports "DDR3_DQS_P[7]"]
set_property  SLEW        FAST          [get_ports "DDR3_DQS_P[7]"]
set_property  PACKAGE_PIN AD1           [get_ports "DDR3_DQS_N[7]"]
set_property  IOSTANDARD  DIFF_SSTL135_T_DCI  [get_ports "DDR3_DQS_N[7]"]
set_property  VCCAUX_IO   HIGH          [get_ports "DDR3_DQS_N[7]"]
set_property  SLEW        FAST          [get_ports "DDR3_DQS_N[7]"]

set_property  DCI_CASCADE {32 34} [get_iobanks 33]

# SFP
set_property  PACKAGE_PIN H2            [get_ports "SFP_TX_P[0]"]
set_property  PACKAGE_PIN F2            [get_ports "SFP_TX_P[1]"]
set_property  PACKAGE_PIN G4            [get_ports "SFP_RX_P[0]"]
set_property  PACKAGE_PIN F6            [get_ports "SFP_RX_P[1]"]

set_property  PACKAGE_PIN AB12          [get_ports "SFP_RX_LOS[0]"]
set_property  IOSTANDARD  SSTL135       [get_ports "SFP_RX_LOS[0]"]
set_property  PACKAGE_PIN AA12          [get_ports "SFP_DETECT[0]"]
set_property  IOSTANDARD  SSTL135       [get_ports "SFP_DETECT[0]"]
set_property  PACKAGE_PIN AB8           [get_ports "SFP_RX_LOS[1]"]
set_property  IOSTANDARD  SSTL135       [get_ports "SFP_RX_LOS[1]"]
set_property  PACKAGE_PIN AA8           [get_ports "SFP_DETECT[1]"]
set_property  IOSTANDARD  SSTL135       [get_ports "SFP_DETECT[1]"]

set_property  PACKAGE_PIN G8            [get_ports "MGTCLK117_P0"]
set_property  PACKAGE_PIN J8            [get_ports "MGTCLK117_P1"]

# AMC
set_property  PACKAGE_PIN K2            [get_ports "AMC_TX_P0"]
set_property  PACKAGE_PIN J4            [get_ports "AMC_TX_P1"]
set_property  PACKAGE_PIN K6            [get_ports "AMC_RX_P0"]
set_property  PACKAGE_PIN H6            [get_ports "AMC_RX_P1"]

set_property  PACKAGE_PIN Y2            [get_ports "AMC_TX_P4"]
set_property  PACKAGE_PIN V2            [get_ports "AMC_TX_P5"]
set_property  PACKAGE_PIN U4            [get_ports "AMC_TX_P6"]
set_property  PACKAGE_PIN T2            [get_ports "AMC_TX_P7"]
set_property  PACKAGE_PIN AA4           [get_ports "AMC_RX_P4"]
set_property  PACKAGE_PIN Y6            [get_ports "AMC_RX_P5"]
set_property  PACKAGE_PIN W4            [get_ports "AMC_RX_P6"]
set_property  PACKAGE_PIN V6            [get_ports "AMC_RX_P7"]

set_property  PACKAGE_PIN R8            [get_ports "MGTCLK115_P0"]
set_property  PACKAGE_PIN U8            [get_ports "MGTCLK115_P1"]

set_property  PACKAGE_PIN T22           [get_ports "AMC_TX_P12"]
set_property  IOSTANDARD  LVDS_25       [get_ports "AMC_TX_P12"]
set_property  PACKAGE_PIN T23           [get_ports "AMC_TX_N12"]
set_property  IOSTANDARD  LVDS_25       [get_ports "AMC_TX_N12"]
set_property  PACKAGE_PIN U22           [get_ports "AMC_TX_P13"]
set_property  IOSTANDARD  LVDS_25       [get_ports "AMC_TX_P13"]
set_property  PACKAGE_PIN U23           [get_ports "AMC_TX_N13"]
set_property  IOSTANDARD  LVDS_25       [get_ports "AMC_TX_N13"]
set_property  PACKAGE_PIN W21           [get_ports "AMC_TX_P14"]
set_property  IOSTANDARD  LVDS_25       [get_ports "AMC_TX_P14"]
set_property  PACKAGE_PIN W22           [get_ports "AMC_TX_N14"]
set_property  IOSTANDARD  LVDS_25       [get_ports "AMC_TX_N14"]
set_property  PACKAGE_PIN V25           [get_ports "AMC_TX_P15"]
set_property  IOSTANDARD  LVDS_25       [get_ports "AMC_TX_P15"]
set_property  PACKAGE_PIN W26           [get_ports "AMC_TX_N15"]
set_property  IOSTANDARD  LVDS_25       [get_ports "AMC_TX_N15"]

set_property  PACKAGE_PIN W23           [get_ports "AMC_RX_P12"]
set_property  IOSTANDARD  LVDS_25       [get_ports "AMC_RX_P12"]
set_property  PACKAGE_PIN W24           [get_ports "AMC_RX_N12"]
set_property  IOSTANDARD  LVDS_25       [get_ports "AMC_RX_N12"]
set_property  PACKAGE_PIN T20           [get_ports "AMC_RX_P13"]
set_property  IOSTANDARD  LVDS_25       [get_ports "AMC_RX_P13"]
set_property  PACKAGE_PIN T21           [get_ports "AMC_RX_N13"]
set_property  IOSTANDARD  LVDS_25       [get_ports "AMC_RX_N13"]
set_property  PACKAGE_PIN V19           [get_ports "AMC_RX_P14"]
set_property  IOSTANDARD  LVDS_25       [get_ports "AMC_RX_P14"]
set_property  PACKAGE_PIN V20           [get_ports "AMC_RX_N14"]
set_property  IOSTANDARD  LVDS_25       [get_ports "AMC_RX_N14"]
set_property  PACKAGE_PIN U24           [get_ports "AMC_RX_P15"]
set_property  IOSTANDARD  LVDS_25       [get_ports "AMC_RX_P15"]
set_property  PACKAGE_PIN V24           [get_ports "AMC_RX_N15"]
set_property  IOSTANDARD  LVDS_25       [get_ports "AMC_RX_N15"]

#-------------------------------------------------------------------------------
# Timing exceptions
#-------------------------------------------------------------------------------
# Asynchronous reset crossing into the SiTCP PCS/PMA core.
#
# The user reset (reset_usrclk, generated in the 125 MHz clk_out3 domain) is
# consumed by gig_ethernet_pcs_pma in its 40 MHz clk_out1 domain.  The core's
# core_resets_i/pma_reset_pipe_reg[*] is an asynchronous-preset reset stretcher
# (D tied to 0, PRE driven directly by `reset`), i.e. this reset input is
# asynchronous by design and has no functional single-cycle relationship with
# clk_out1.  Timing it as a recovery check against the nearest clk_out3/clk_out1
# edge pair (24 ns -> 25 ns = 1 ns requirement) is therefore meaningless and
# produced a false -0.592 ns violation.  Bound the reset distribution delay
# instead, so the asynchronous release reaches all four preset pins within
# 2.5 ns (10 % of the 25 ns clk_out1 period).
set_max_delay -datapath_only 2.500 \
  -from [get_cells {reset_usrclk/reset_pipe_reg[3]}] \
  -to   [get_pins -hier -filter {NAME =~ *core_resets_i/pma_reset_pipe_reg*/PRE}]
